nguyjo/Project_Prometheus/README.md

# Walla Walla University Prometheus Rocket Project (2025-2026)
