nguyjo/Project_Prometheus/Prometheus Final Presentation.pdf

# Prometheus Rocket Final Presentation

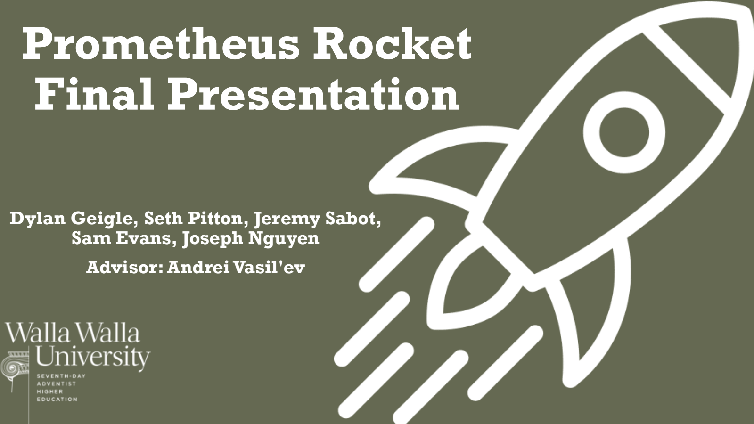
[picture p1: page 1]

Dylan Geigle, Seth Pitton, Jeremy Sabot, Sam Evans, Joseph Nguyen
Advisor: Andrei Vasil'ev

## Previous Projects

Icarus | Vulcan

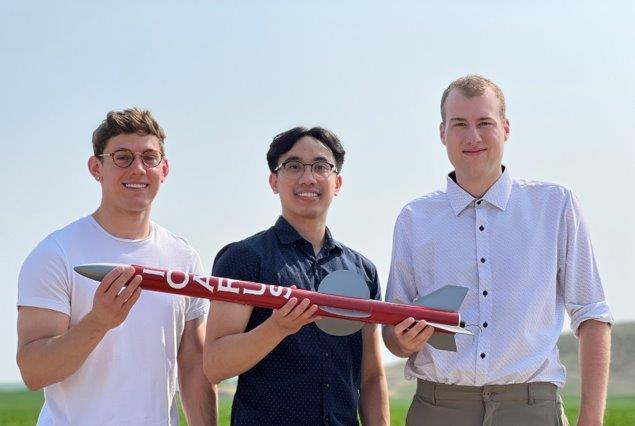
[picture p2: figure]
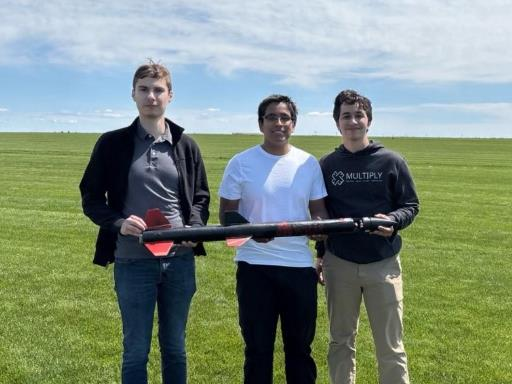
[picture p3: figure]

Figure 1. 2023 Icarus Project Team (Icarus, 2024) | Figure 2. 2024 Vulcan Project Team (Vulcan, 2025)
- Two-Stage, Cardboard
Body Rocket
- Max Altitude: 911 m
- Two-Stage, Fiberglass
Body Rocket
- Max Altitude: 1355 m

## Project Objective

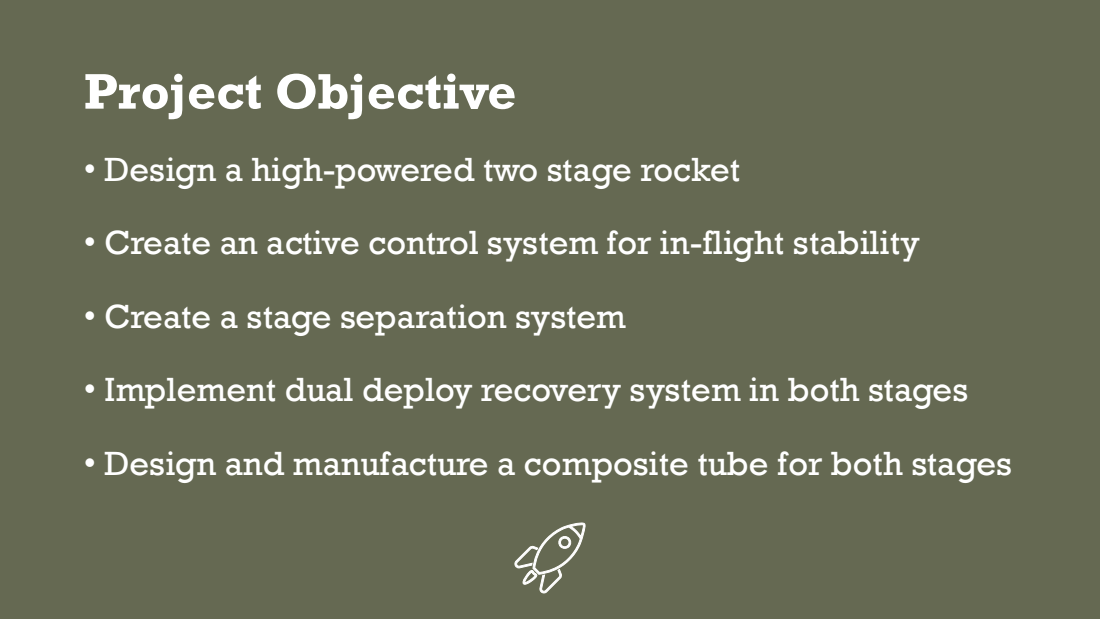
[picture p4: page 3]

• Design a high-powered two stage rocket

• Create an active control system for in-flight stability

• Create a stage separation system

• Implement dual deploy recovery system in both stages

• Design and manufacture a composite tube for both stages

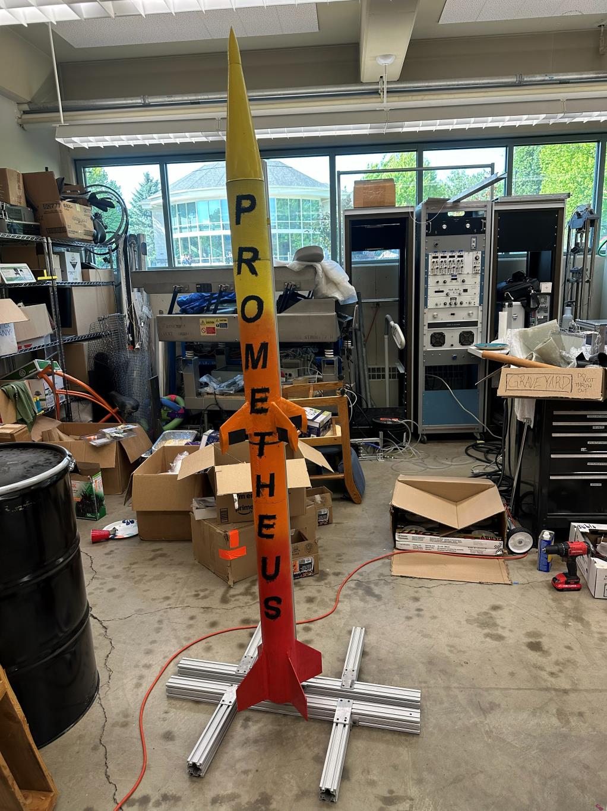
[picture p5: figure]

## Prometheus

- Max Altitude: ~7ft
- Max Velocity: ~75 mph
- We have not launched

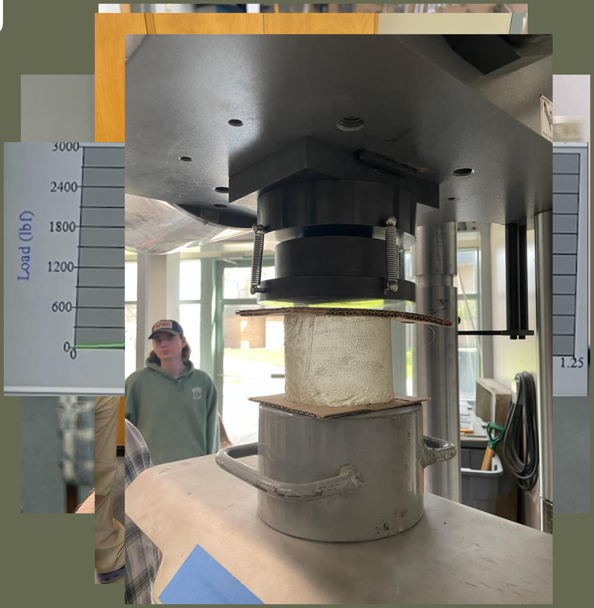
[picture p6: figure]

## Test Section Testing

- 6- layer fiberglass-epoxy composite
- 4in long
- Buckled at 2700lb (12,000N) in compression

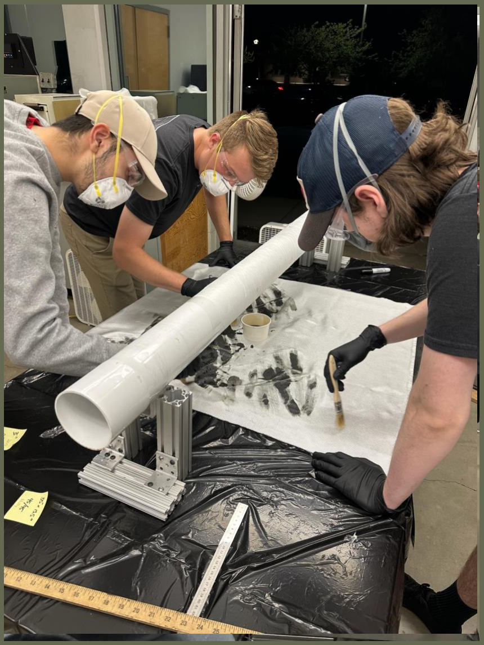
[picture p7: figure]

## Tube Manufacturing

- 6-layer fiberglass [0,45]3
- 0.7 fiber volume fraction
- 2 fiberglass layers wrapped 3 times

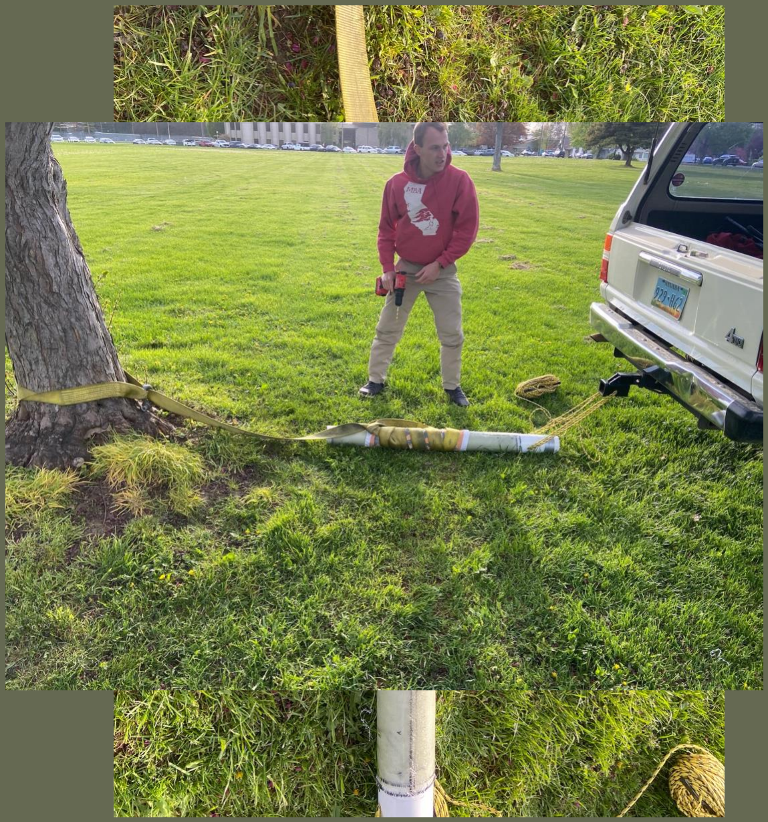
[picture p8: figure]

## Tube Removal

- Methods tried:
- Cut PVC to induce fracture
- Dremel
- Thermal (Hot/Cold)
- Melting the PVC
- Land Cruiser, Tow Strap

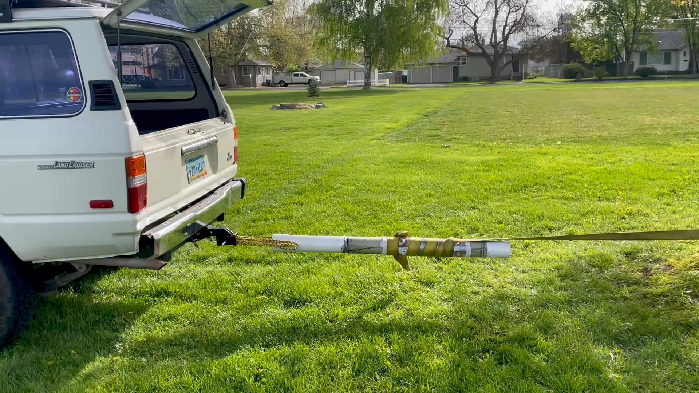
[picture p9: page 8]

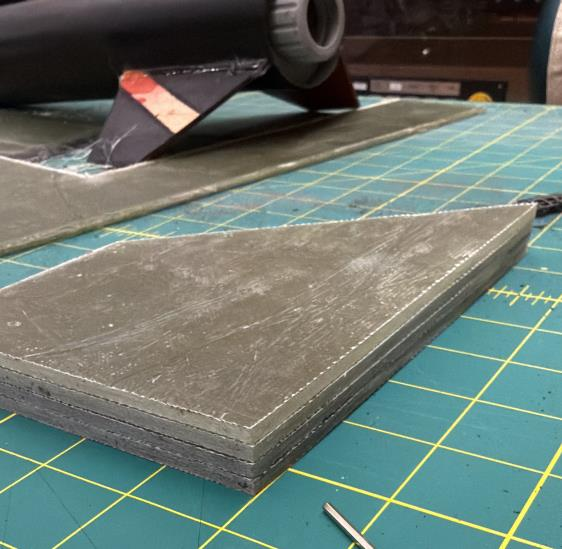
[picture p10: figure]

First Stage Fins Geometry: Trapezoidal fin set, 4 fins Root chord: 18 cm Tip chord: 8 cm Height: 11 cm Sweep length: 10 cm

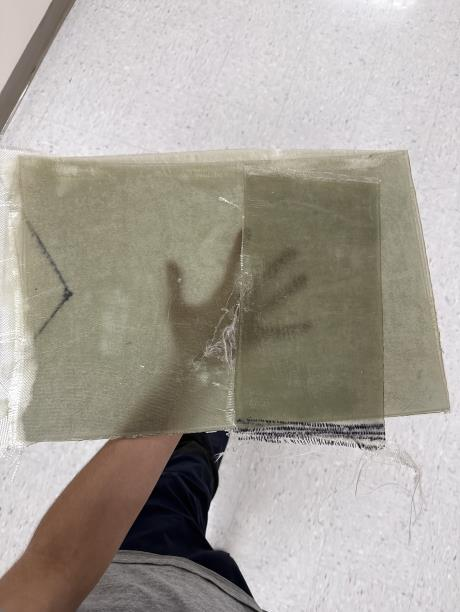
[picture p11: figure]

Manufacturing Method

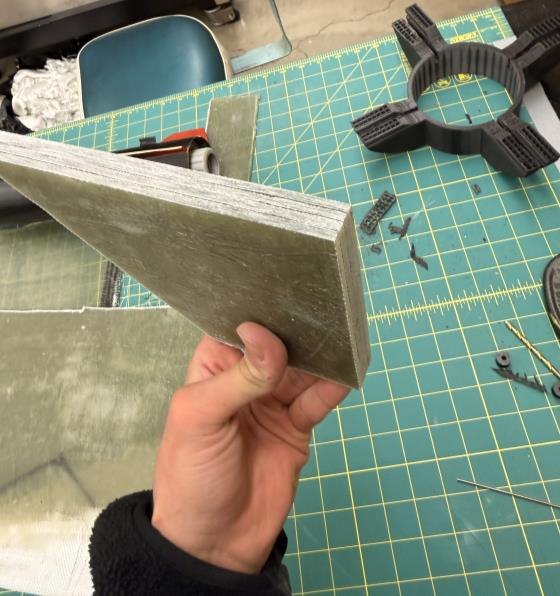
[picture p12: figure]

- Used fin root as the primary datum surface
- Flattened root edge on granite surface plate
- Checked perpendicular reference edge with a square
- Measured remaining geometry from these two references
Why It Mattered
- Improved repeatability between fins
- Reduced angular error during layout
- Helped maintain symmetry and stable flight

## Fin Attachment

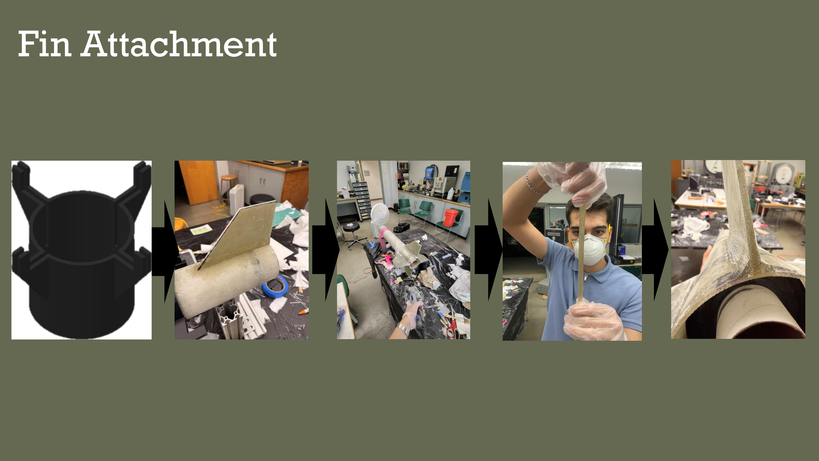
[picture p13: page 10]

## Aerodynamics

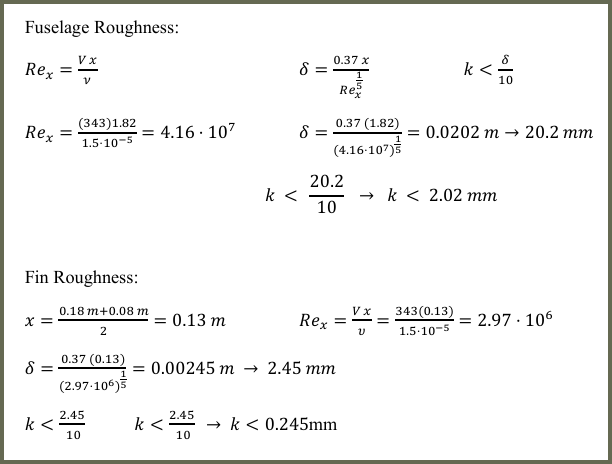
[picture p14: figure]

- Fin Shape Iteration
- Initial idea: symmetric, tapered fin profile
- Looked streamlined for incoming and exiting flow
- OpenRocket stability was too low, about 1.3 cal
- Swept-back design moved CP rearward and improved stability
- Why Sweep Back Helped

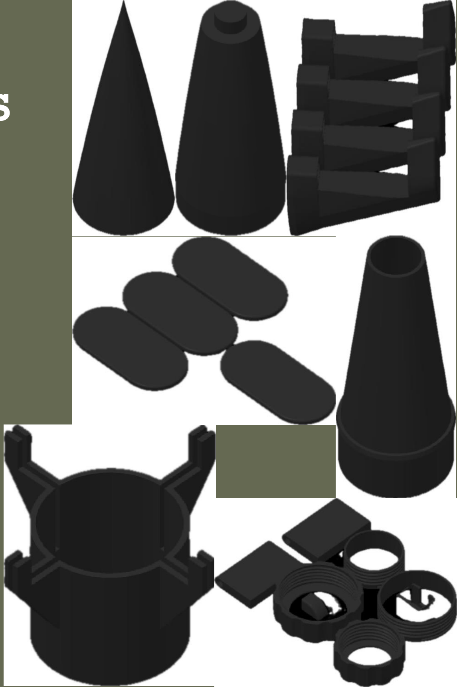
[picture p15: figure]

## 3D Printing considerations

- Stress Concentrations
- Strength Settings
- Infill Choice
- Total Printing Time: 140+ hours

## What was learned about Epoxy Resin

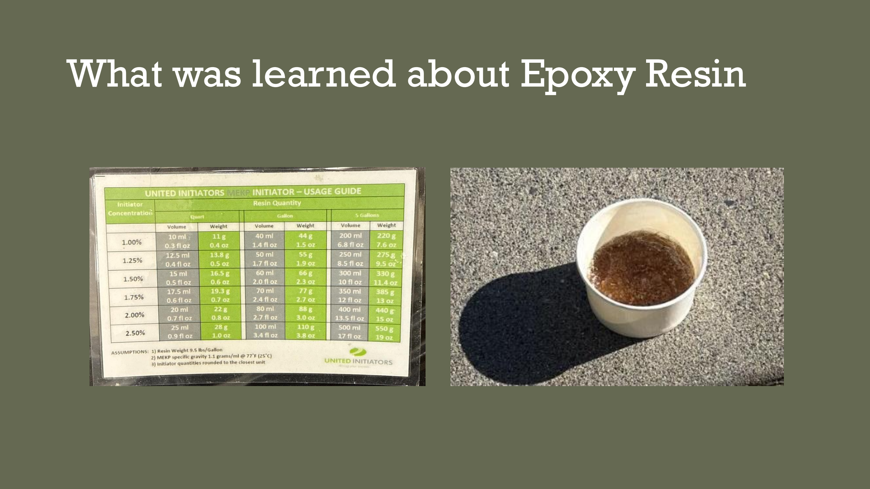
[picture p16: page 13]

2

## nd Stage Fin Manufacturing

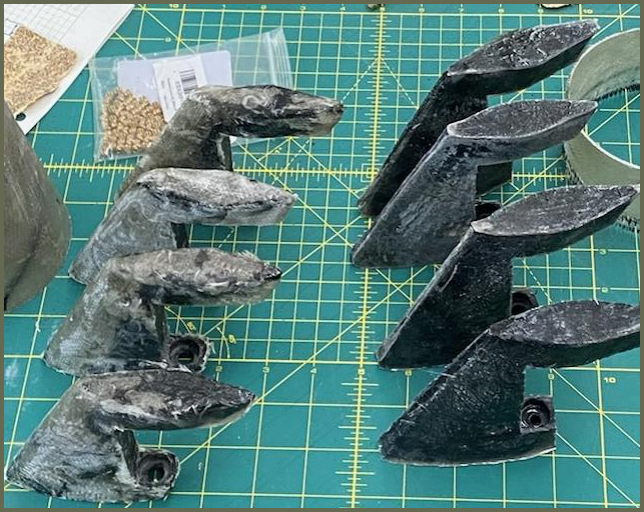
[picture p17: figure]

- 2mm thick fiberglass
- Vacuum bag to remove air bubbles
- 3d printed mold

## Control Surface Assembly

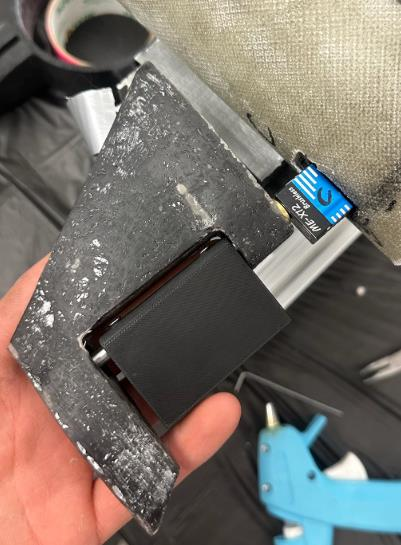
[picture p18: figure]

In House Manufactured
- Fin body (fiberglass)
- Fin Tab (3d printed)
- Shaft (1/4 in steel rod)

Purchased parts
- Servo to shaft couplers
- Bearings
- Screws

## Control Surface Assembly

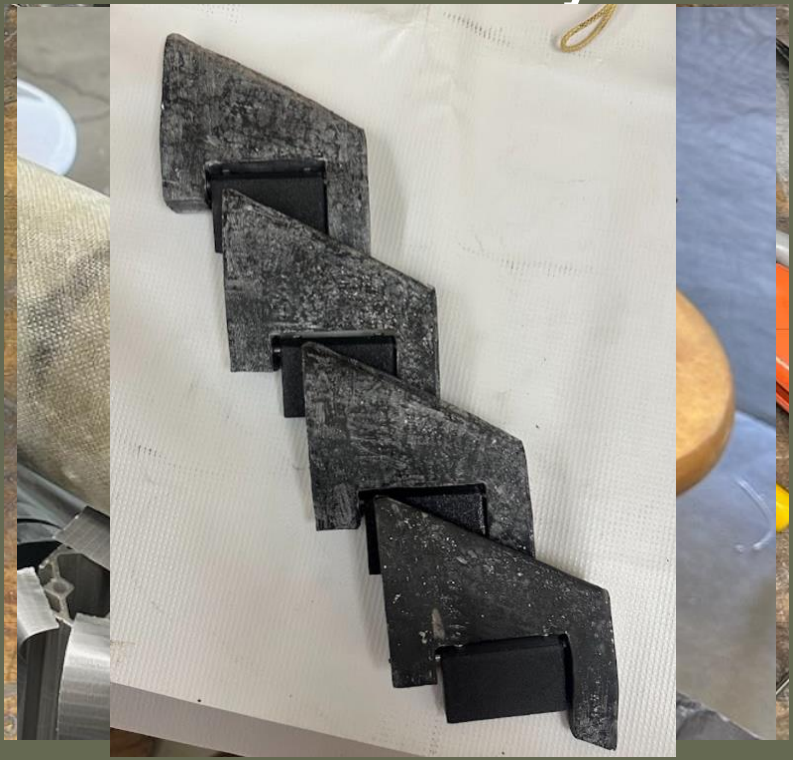
[picture p19: figure]

## What didn’t work

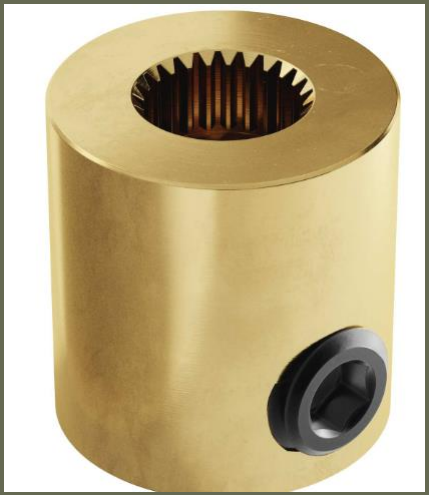
[picture p20: figure]

- Servo to shaft couplers
didn’t fit
- Solutions to this problem included plastic parts, and jb weld
- This was relatively
unsuccessful

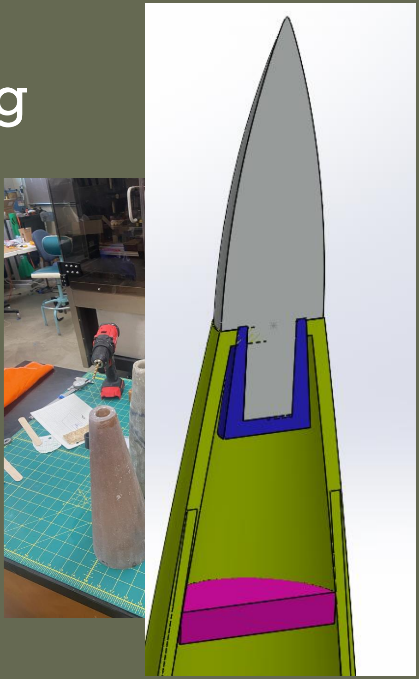
[picture p21: figure]

## Nosecone Manufacturing

- 4mm thick fiberglass
- Vacuum bag to remove air
bubbles
- 3d printed mold

## Centering Ring Redesign

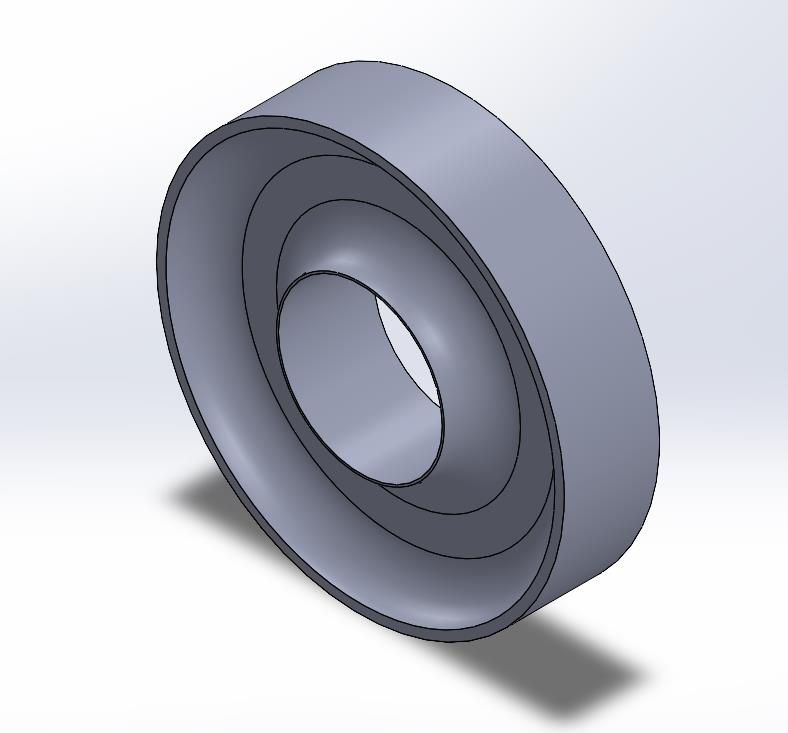
[picture p22: figure]

- Fillets had issues printing
- Increased top surface area
- Added skirts along the
outside of the rings to
increase surface adhesion

## 1st Stage Motor Mount Assembly

- Same as 2nd stage without
wires

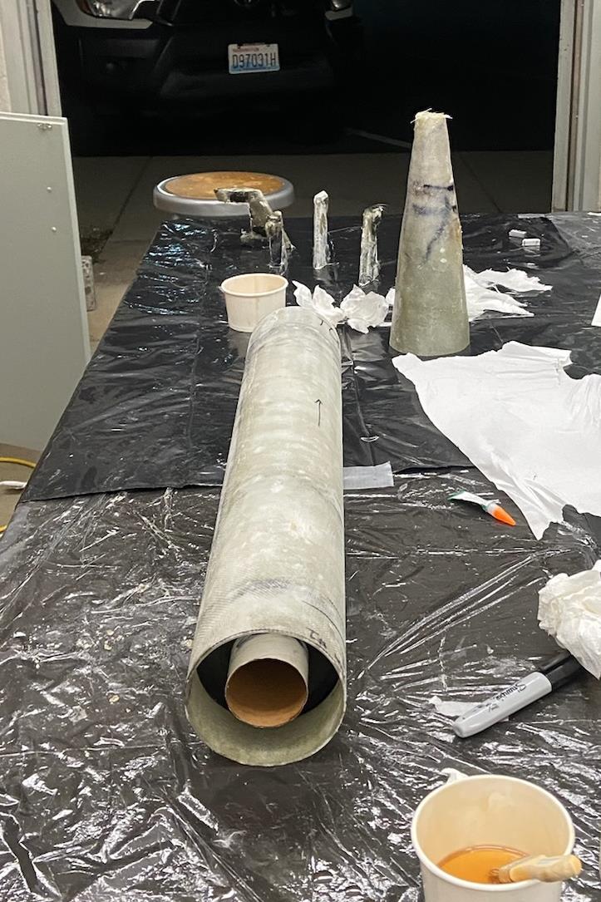
[picture p23: figure]
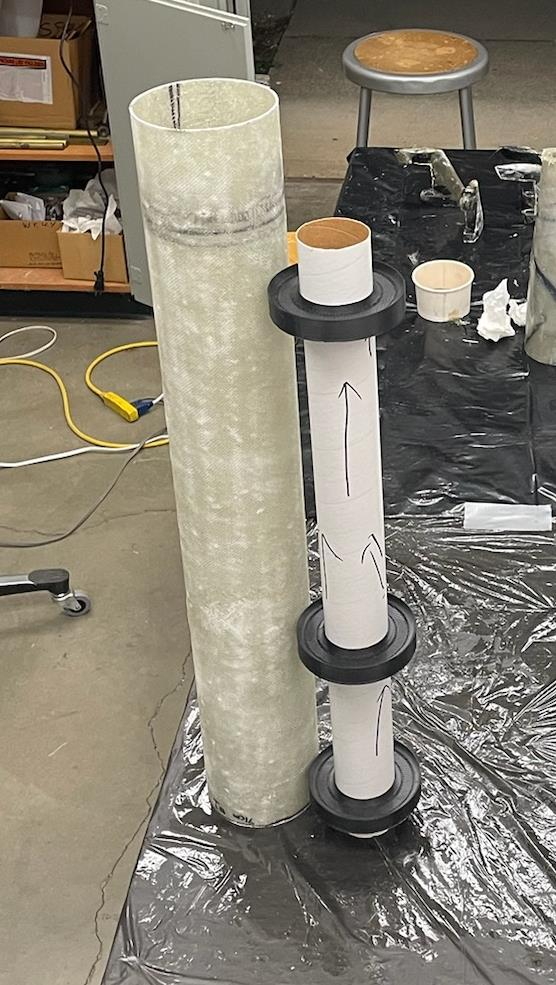
[picture p24: figure]

## 2nd Stage Motor Mount Assembly

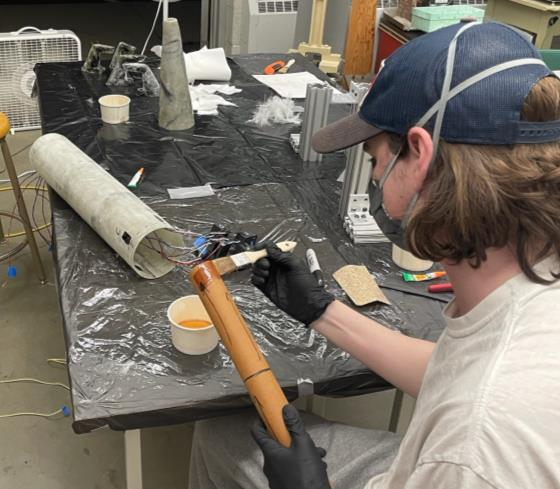
[picture p25: figure]
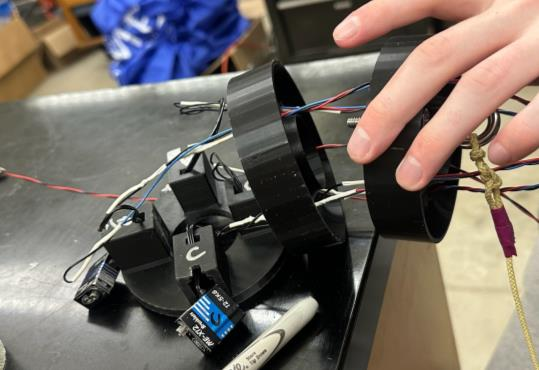
[picture p26: figure]

- Assembled outside of body
tube
- Epoxied top centering ring before motor tube
- Servos ran back through
mounting ring before
glueing in the bottom ring

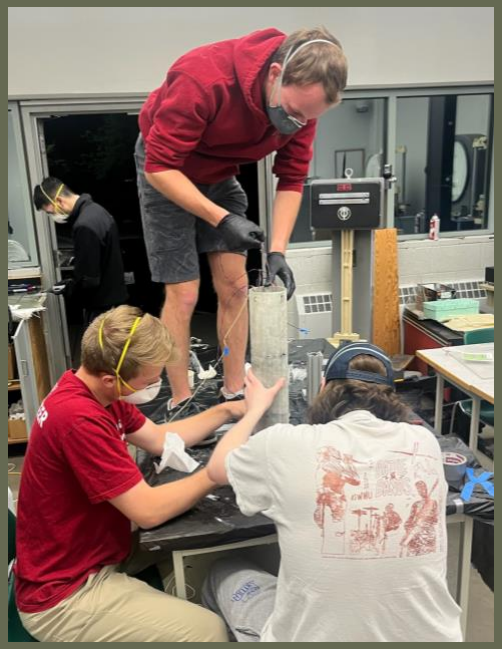
[picture p27: figure]
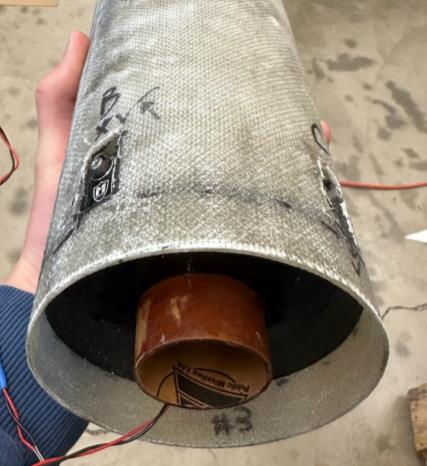
[picture p28: figure]

## First Stage Electronics Bay

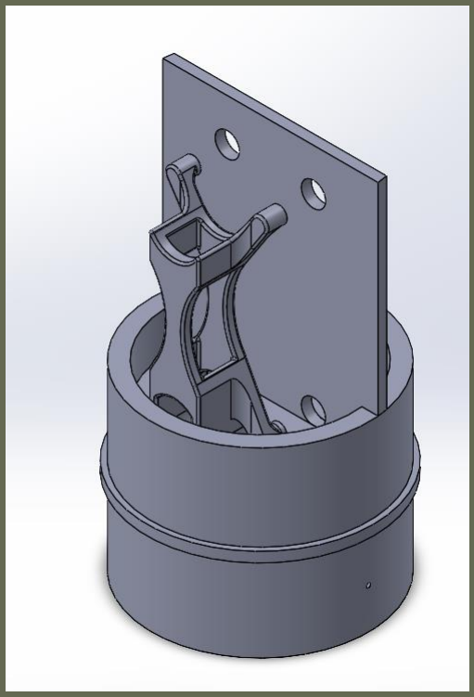
[picture p29: figure]

- Electronics
- Dual Deploy Bay
- Interstage Coupler

2

## nd Stage Electronics Bay Assembly

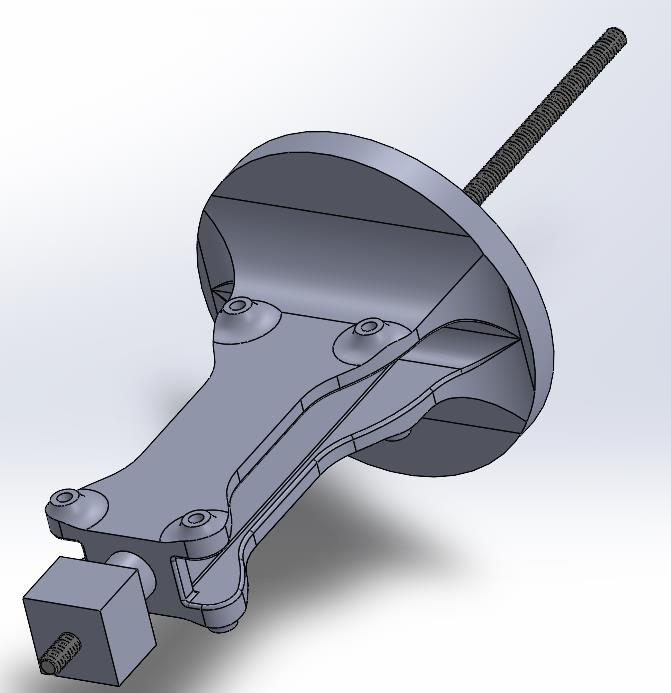
[picture p30: figure]

- Brass M3 Threaded Inserts
- Rubber washers to dampen vibration
- Large fillets for to reduce stress concentration
- Threaded rod to transfer force
- Space for 2 circuits boards, batteries

## System Block Diagram

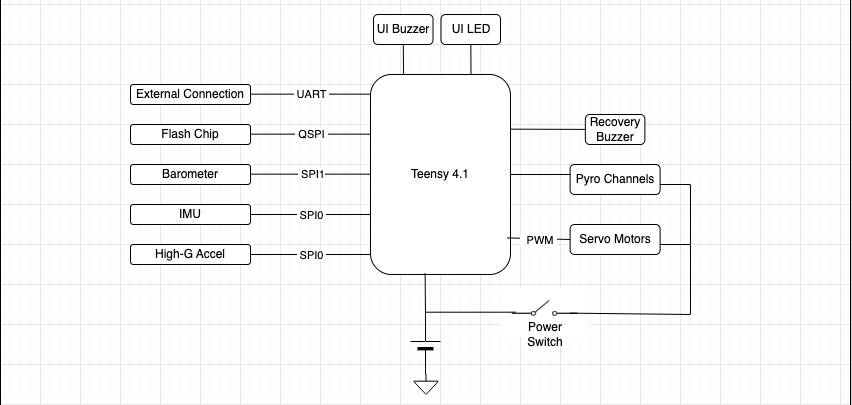
[picture p31: page 24]

## Sustainer Motor Safety Gates

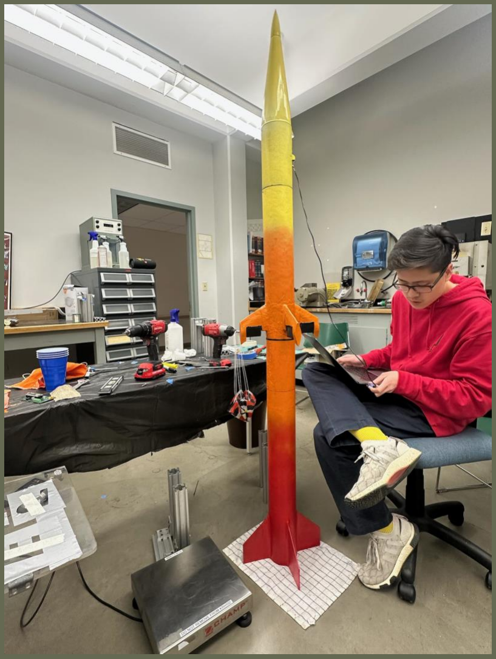
[picture p32: figure]

- Power Switch Closed
- Software Arm
- External Connection
Disconnected
- Pyro Channel Continuity
Sensing
- Booster Coast Time Elapsed
- Tilt Lockout

## Flight State Machines

Booster
- Pre-Liftoff
- Booster Ignition
- Booster Coast
- Drogue Parachute
- Main Parachute
- Touchdown

Sustainer
- Pre-Liftoff
- Booster Ignition
- Booster Coast
- Sustainer Ignition
- Sustainer Coast
- Drogue Parachute
- Main Parachute
- Touchdown

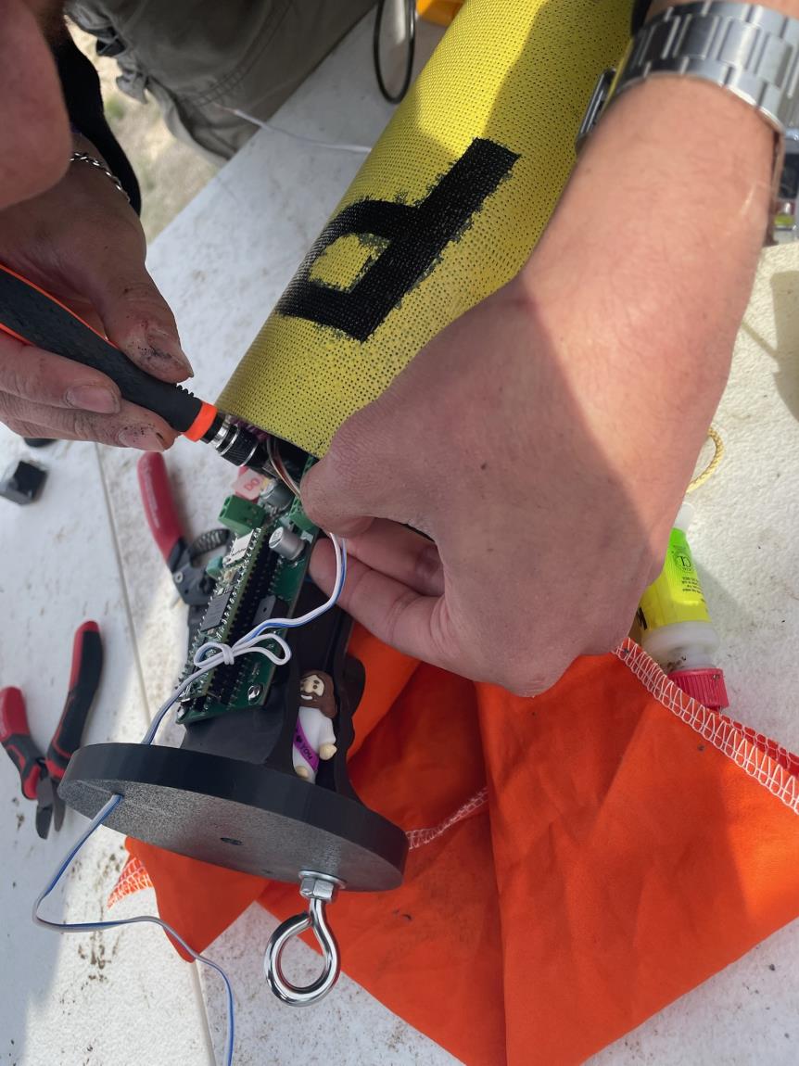
[picture p33: figure]

## Pre-Flight Safety Protocol

- Command-Line Interface (CLI)
over an External Connection
oCalibrate Sensors
- Software Arming
oBattery Voltage Monitor
oCheck Servos
- Pyro Channel Continuity
oCheck correct Firmware Upload

## Control System Block Diagram

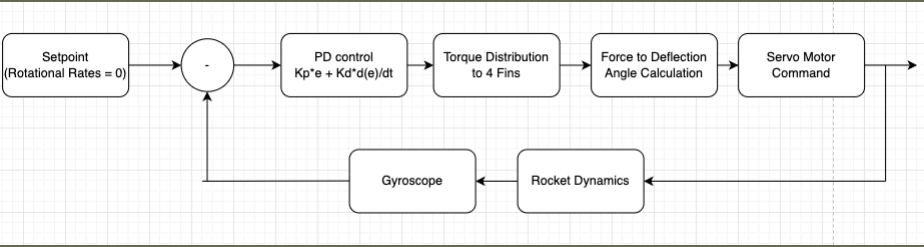
[picture p34: figure]

## Servo Motor Misalignment

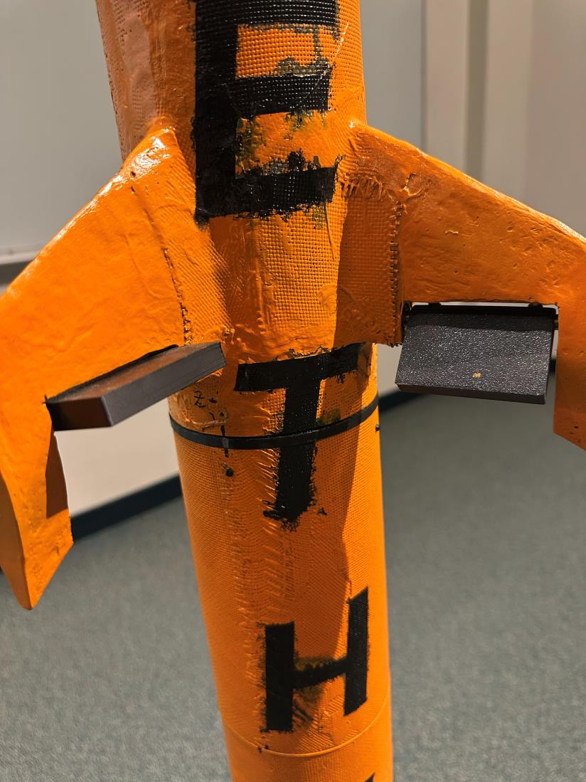
[picture p35: figure]

- During assembly, servo horns were pressed onto the splines at incorrect teeth
- Software trim/offset
can correct residual
misalignment to only a few degrees
- At commanded "neutral"
(PWM 90°), some fin tabs sat 55°+ off parallel-to-airframe

## Sam Does Electrical Engineering

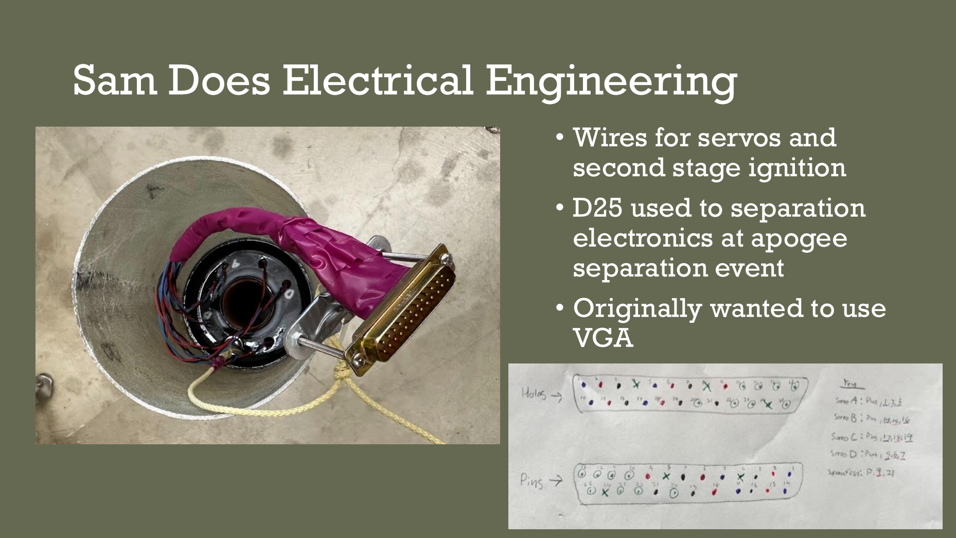
[picture p36: page 30]

- Wires for servos and
second stage ignition
- D25 used to separation
electronics at apogee
separation event
- Originally wanted to use VGA

## Camera Housing

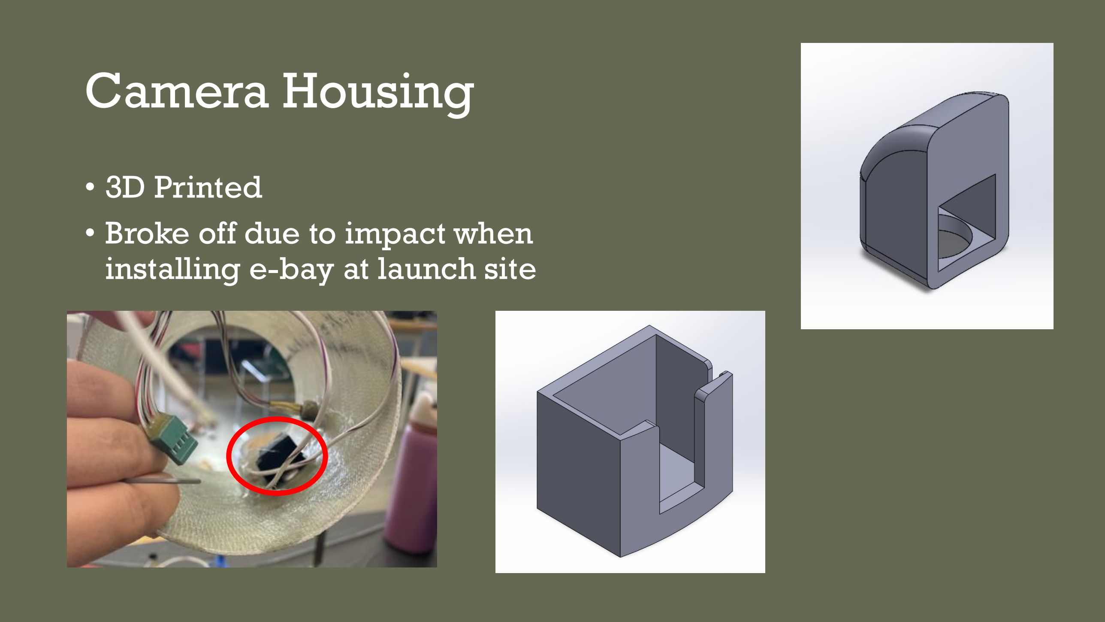
[picture p37: page 31]

- 3D Printed
- Broke off due to impact when installing e-bay at launch site

## Motors

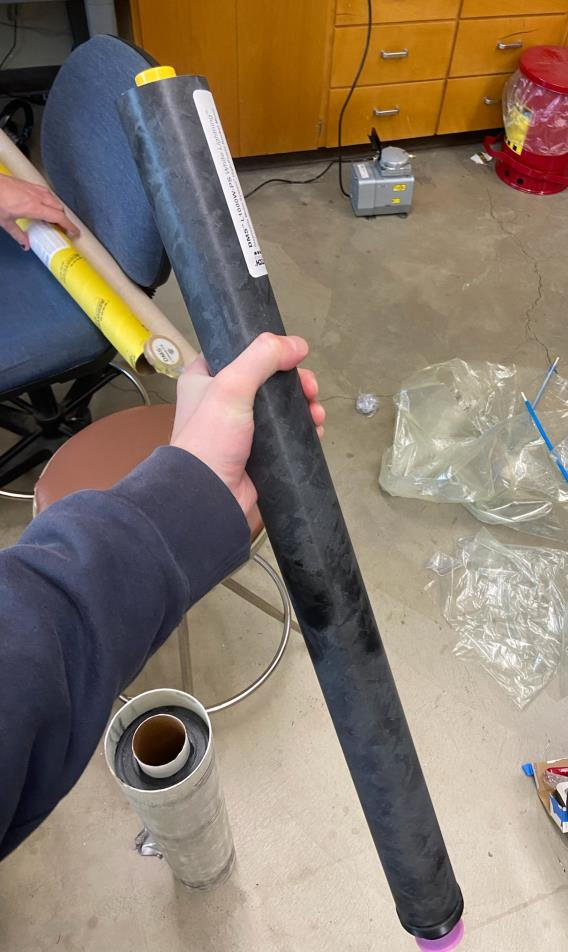
[picture p38: figure]
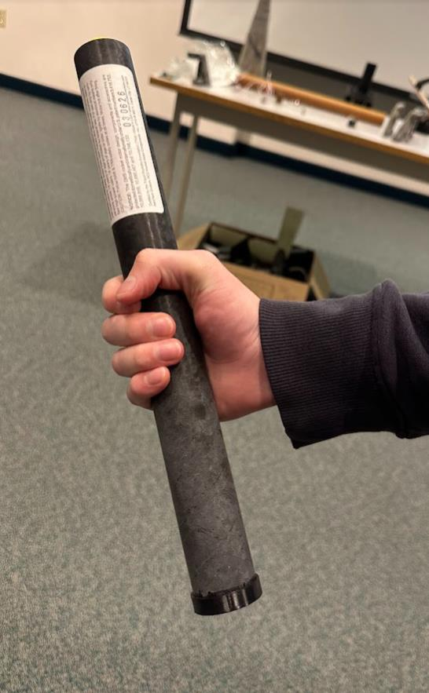
[picture p39: figure]

- L1000-18
- Burn Time: 3s
- Coast Time: 7s
- Max Thrust: 1355N
- J435-14
- Burn Time: 1.78s
- Coast Time: 14s
- Max Thrust: 696N

## Motor Retention Caps

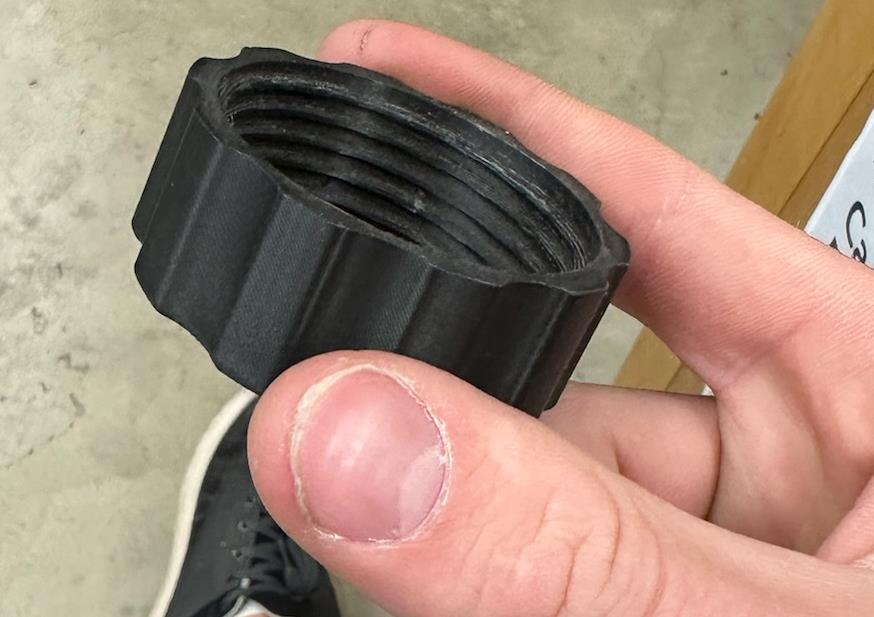
[picture p40: figure]
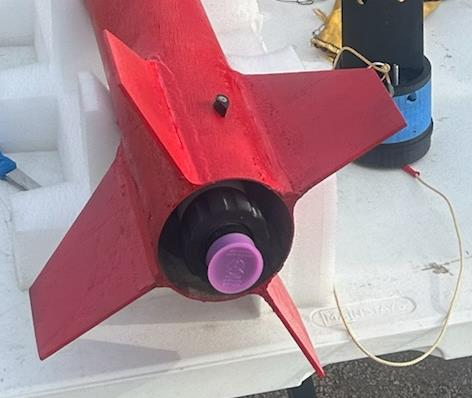
[picture p41: figure]
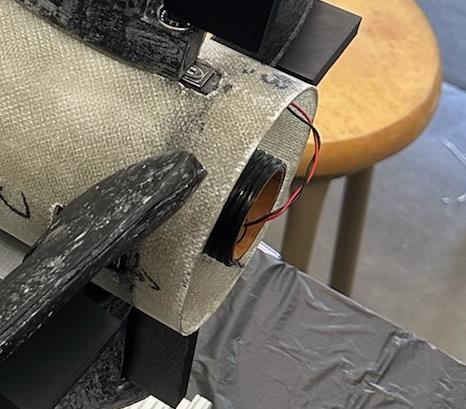
[picture p42: figure]
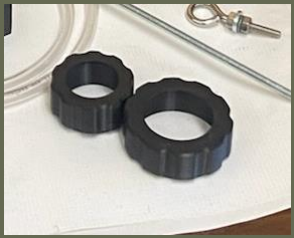
[picture p43: figure]

- Made to hold the motors in
the mounting tubes
- 3d printed
- Epoxied onto the motor
mount tubes

## Recovery

- The recovery system went together as intended
- Assemblies approved for
flight after intense
questioning

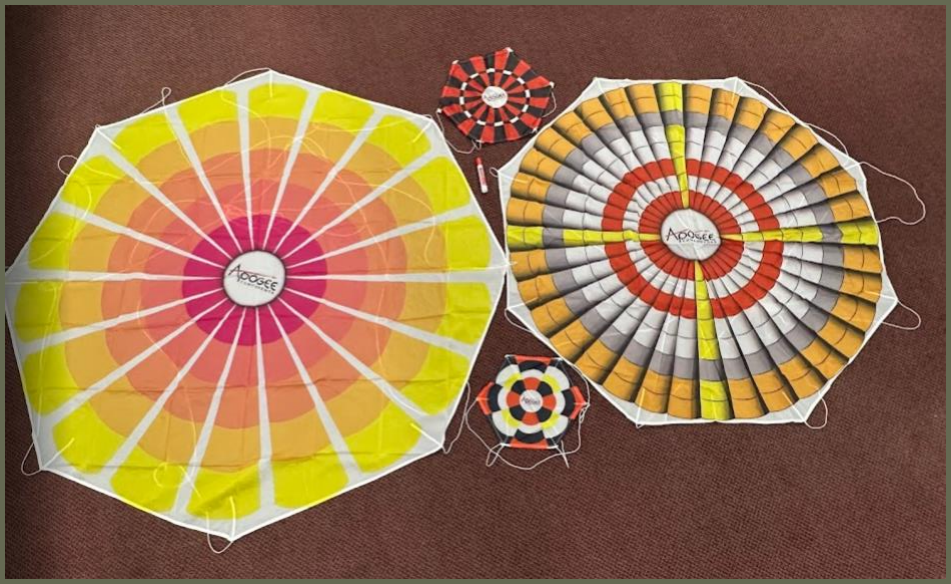
[picture p44: figure]

## Charges

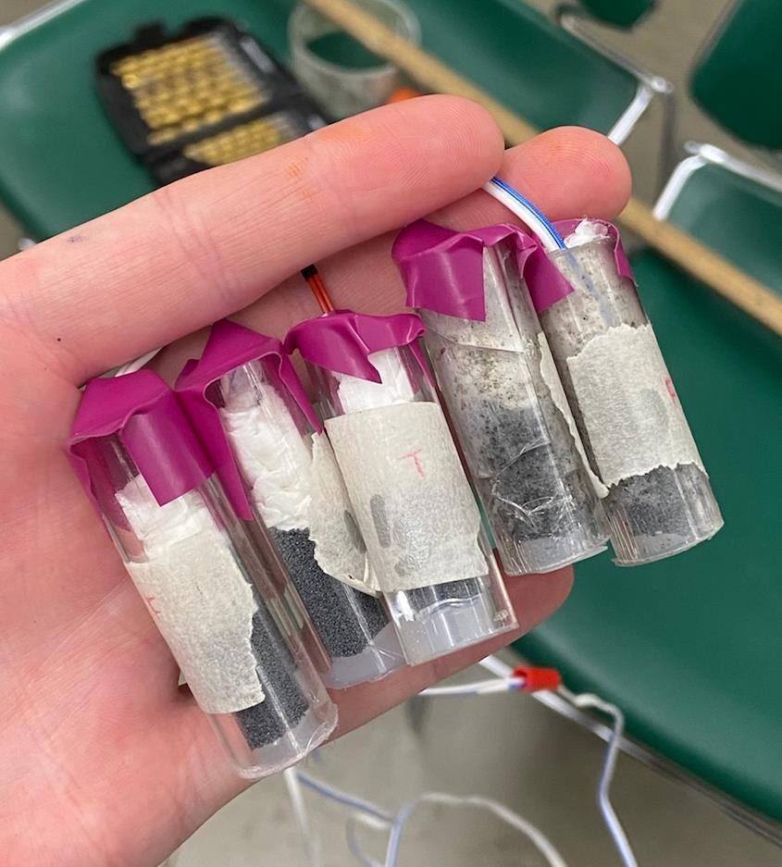
[picture p45: figure]

- Initial
- H335 Rifle Powder
- Tested with 7g+
- Final
- Triple Seven FFFG
- 1g
- Finer and more energetic than H335
- Plastic Tubing
- Hot glue
- Paper towel

## Charge Testing

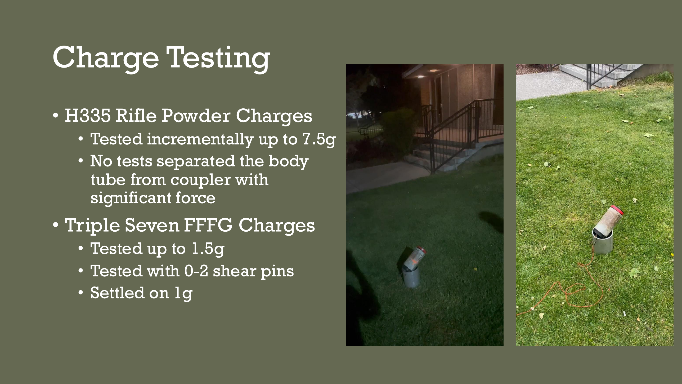
[picture p46: page 36]

- H335 Rifle Powder Charges
- Tested incrementally up to 7.5g
- No tests separated the body tube from coupler with
significant force
- Triple Seven FFFG Charges
- Tested up to 1.5g
- Tested with 0-2 shear pins
- Settled on 1g

## Final Assembly

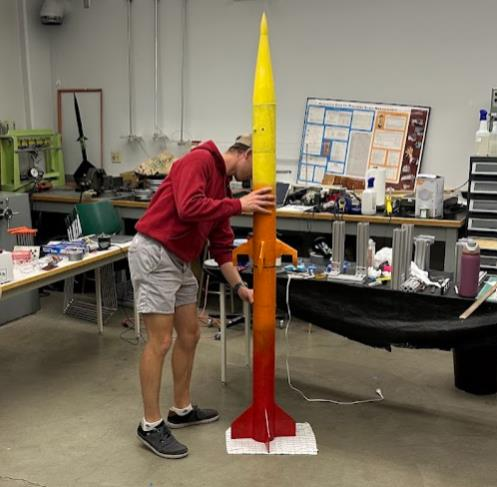
[picture p47: figure]

- Chute lines tied off
- Parachutes packed
- Electronics bays aligned
- Shear pins installed
- Final checks made

## OpenRocket Projections

- Max Velo: 279 m/s (Mach 0.8)
- Max Acceleration: 173 m/s^2
- Apogee: 3220 m (~10.5k ft)
- Weight: 8 kg
- Weight (no motors): 5.2 kg
- Real Weight: 4.92 kg

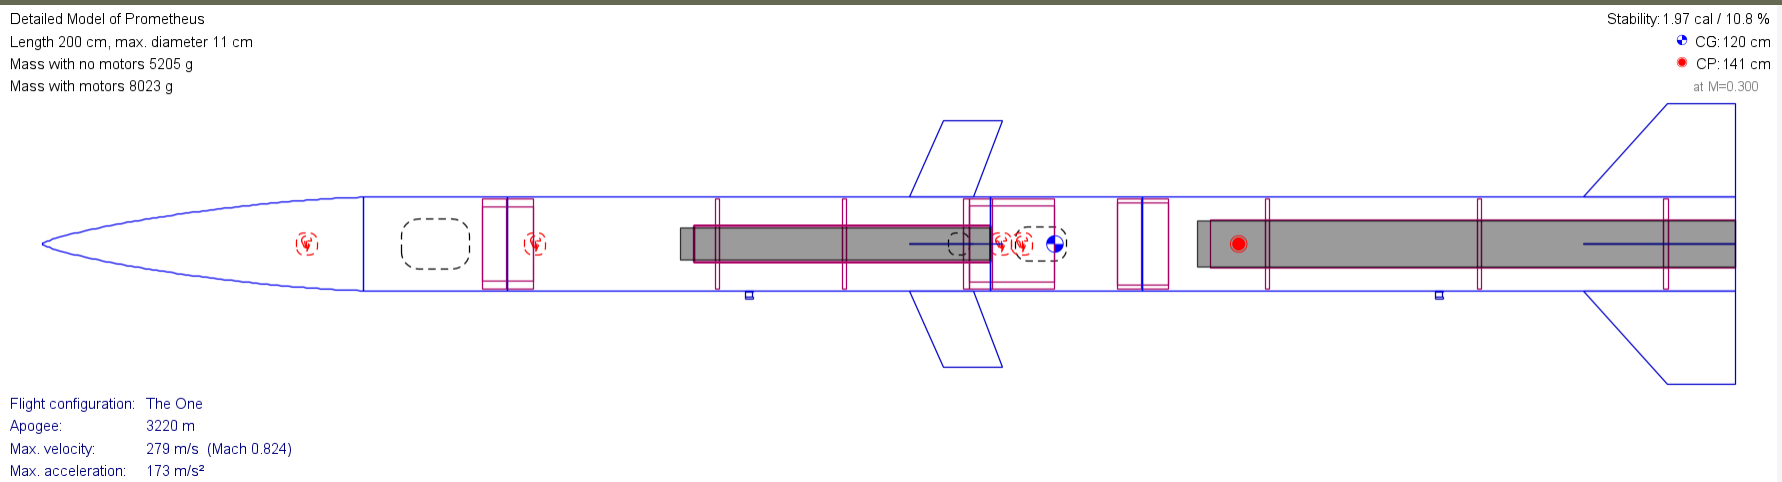
[picture p48: figure]

# Budget

| Electronics | Motors | Miscellaneous | Total
Cost | $963.55 | $442 | $270.63 | $1676.28

## So Why Did Prometheus Not Launch?

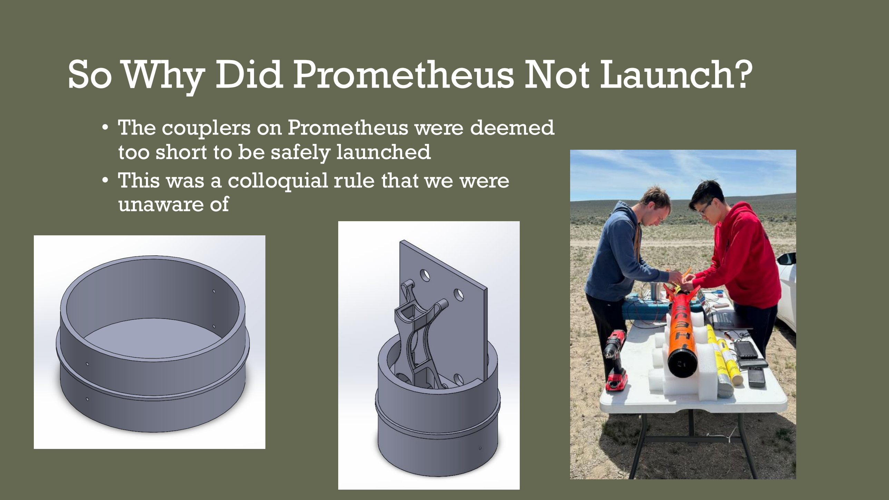
[picture p49: page 40]

- The couplers on Prometheus were deemed too short to be safely launched
- This was a colloquial rule that we were unaware of

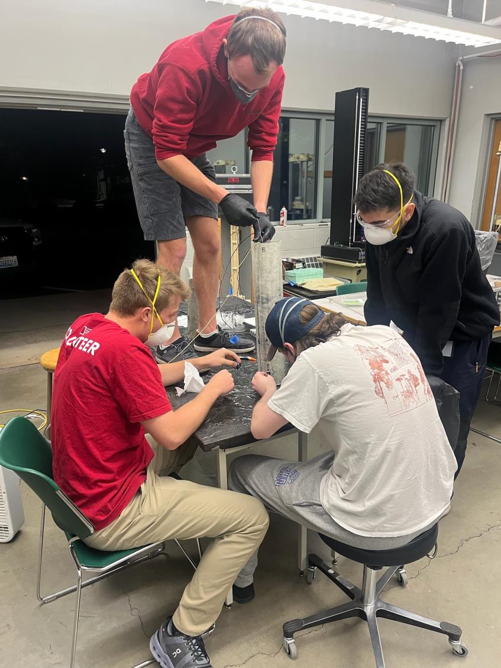
[picture p50: figure]

## Man Hours

- In total roughly 1400+ man hours to build
- Capstone requires 150 per person
- That’s roughly 9 people in project hours
| Fall | Winter | Spring | Quarter Totals | Total
Dylan | 64 | 87 | 124 | 275 | 1417
Sam | 56 | 79 | 144 | 279
Seth | 65 | 71 | 144 | 280
Jeremy | 50 | 70 | 130 | 250
Joseph | 60 | 78 | 160 | 298
Andrei | 5 | 10 | 35 | 50

## Advice to Future Projects (That We Wish We Knew)

- Hardware-in-the-Loop (HIL) testing simulation
- Extensive materials testing on epoxy, PETG and
assembly hardware
Problems from our Rocket:
- Redesign couplers
- Solve space issue
- Fix brass coupler(s)
- Materials testing
- Leave time for testing

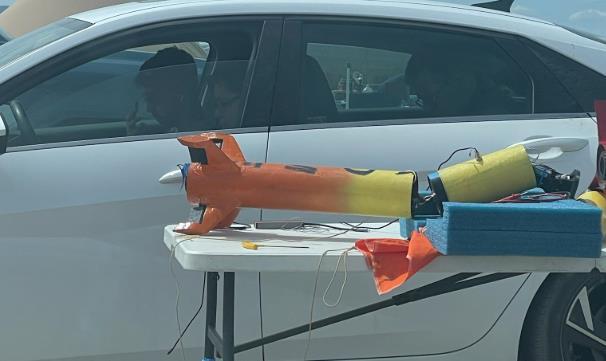
[picture p51: figure]

Credits • Andrei Vasilev • Dr. Thomsen • Reiff Manufacturing • Dr. Ekkens • Andrei Maiorov • Kolby Kriegelstein • Natalie Hunter • Jess Mumek • Dr. Ma • Dr. Yaw

- Cristina Showalter • Toby Pitton • Carena Tomas • Seth Waller • David Bobocea • Colten Hartman • Xander Rusenescu • ASME Club • Sam’s car • Tree on Rogers field

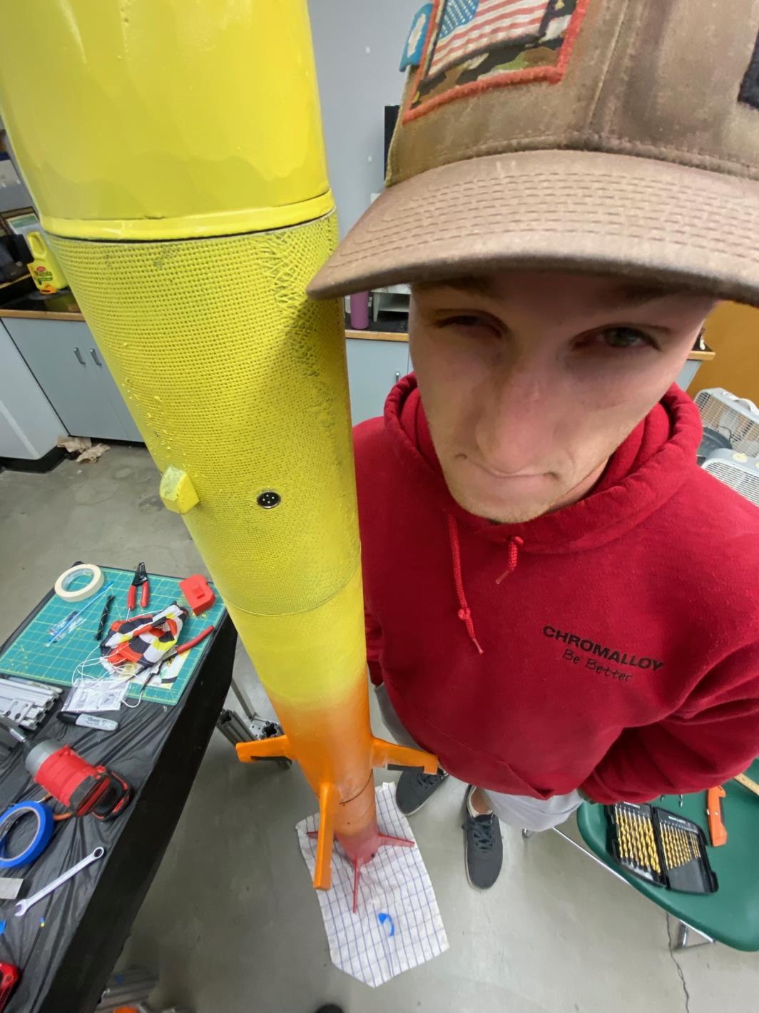
[picture p52: figure]

## Questions?

All uncredited photos were taken by the Prometheus rocket project team
