nguyjo/Project_Prometheus/hardware/KiCAD/Pronoia_Sustainer/CAD Results/Pronoia_Sustainer_v2.0.png

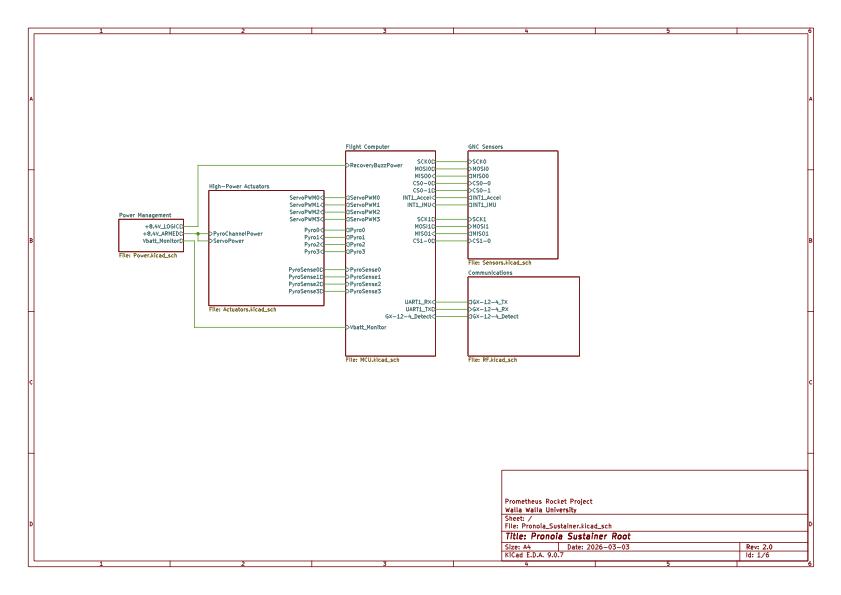
hardware/KiCAD/Pronoia_Sustainer/CAD Results/Pronoia_Sustainer_v2.0.png
