nguyjo/Project_Prometheus/hardware/KiCAD/Pronoia_Sustainer/CAD Results/Pronoia_Sustainer.pdf

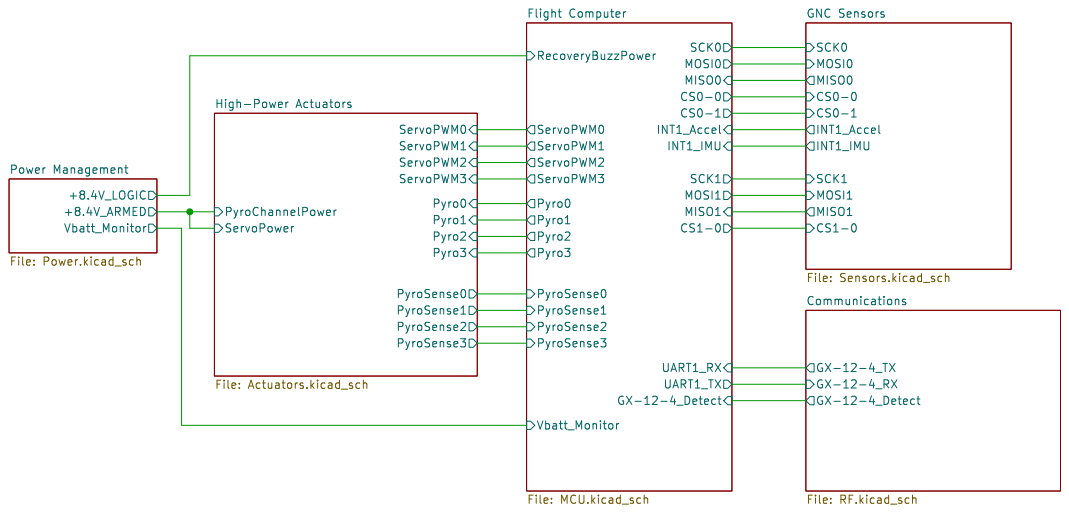
[picture p54: page 1]

INT1_Accel INT1_IMU MISO0 MOSI0 SCK0 CS1-0 MISO1 MOSI1 SCK1 GNC Sensors File: Sensors.kicad_sch GX-12-4_RX GX-12-4_TX GX-12-4_Detect Communications File: RF.kicad_sch Vbatt_Monitor +8.4V_ARMED

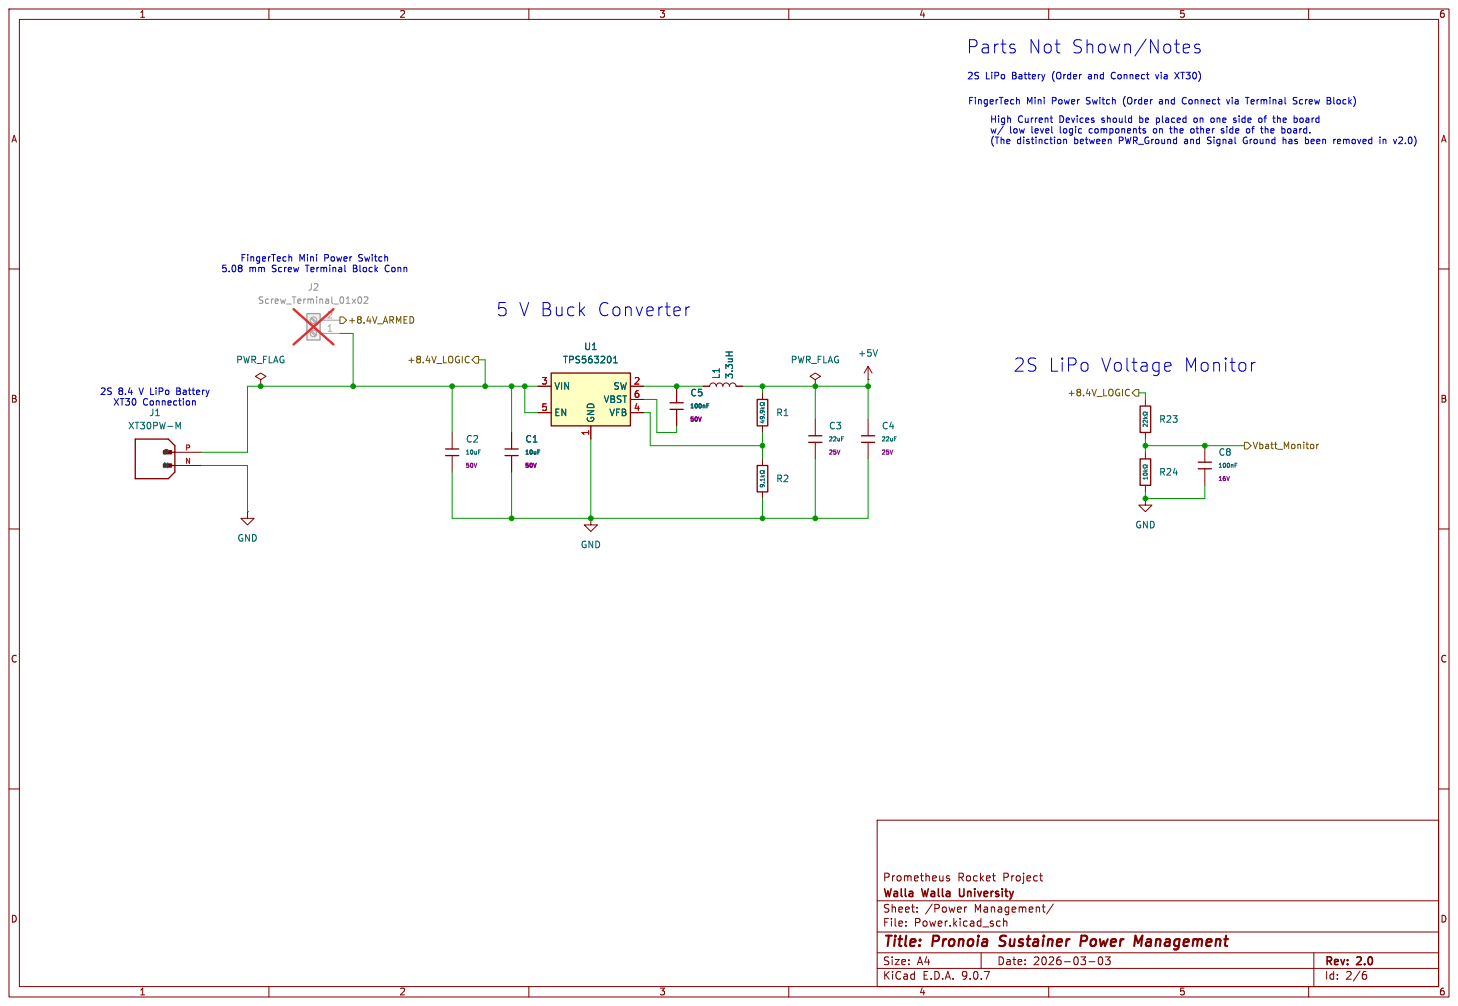
[picture p55: page 2]

FingerTech Mini Power Switch (Order and Connect via Terminal Screw Block) 2S LiPo Battery (Order and Connect via XT30)

FingerTech Mini Power Switch

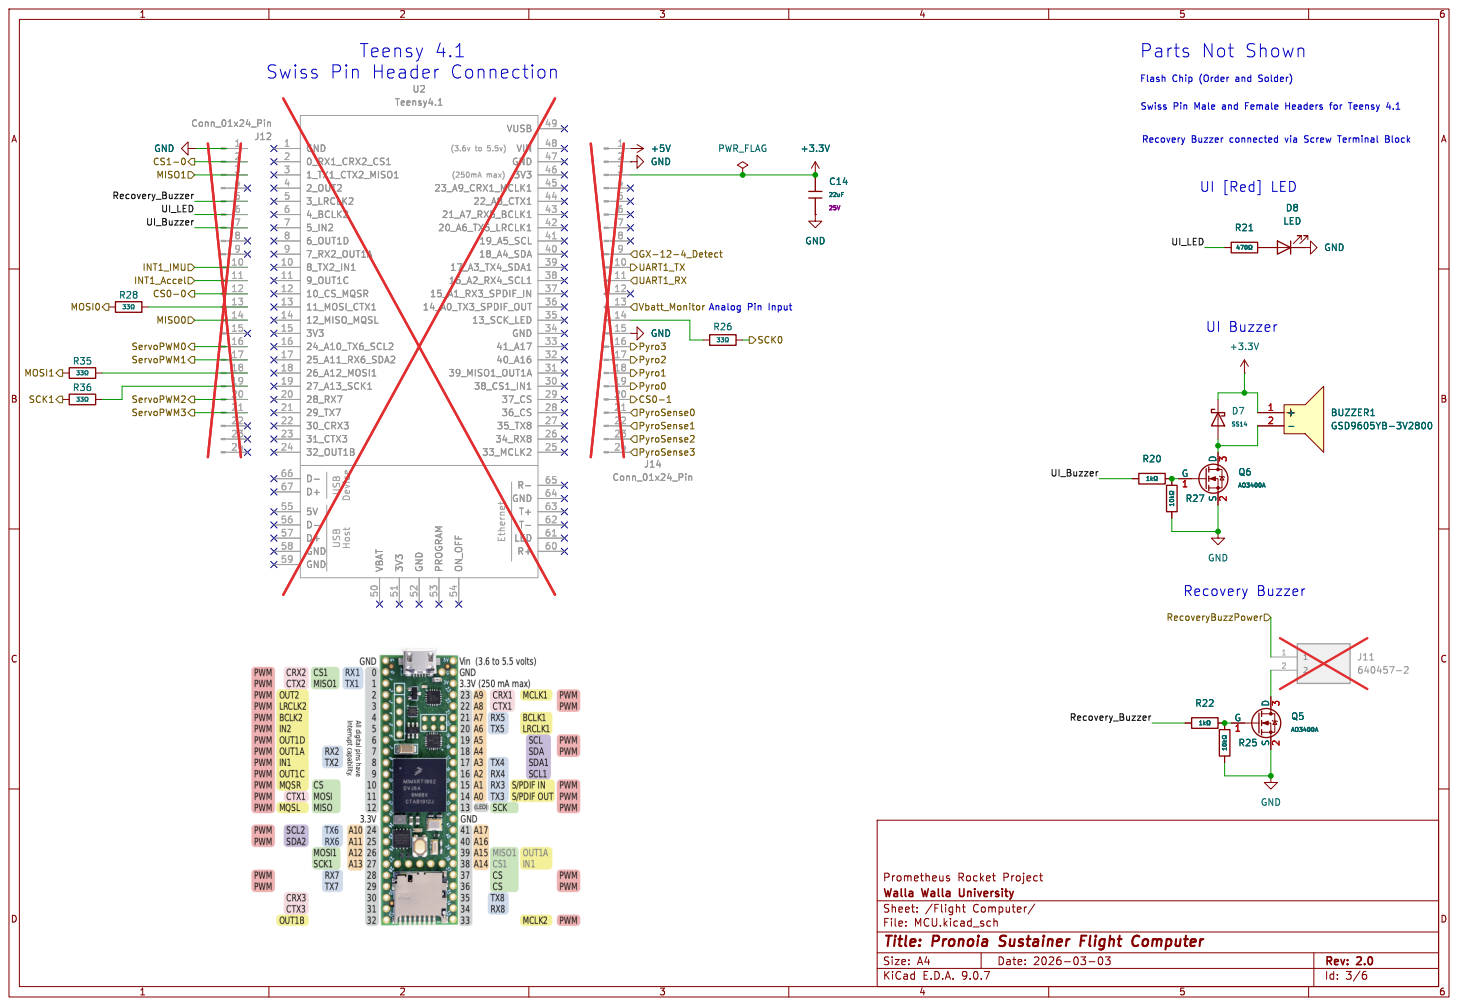
[picture p56: page 3]

Swiss Pin Header Connection

Flash Chip (Order and Solder)

LED USB USB Device Host

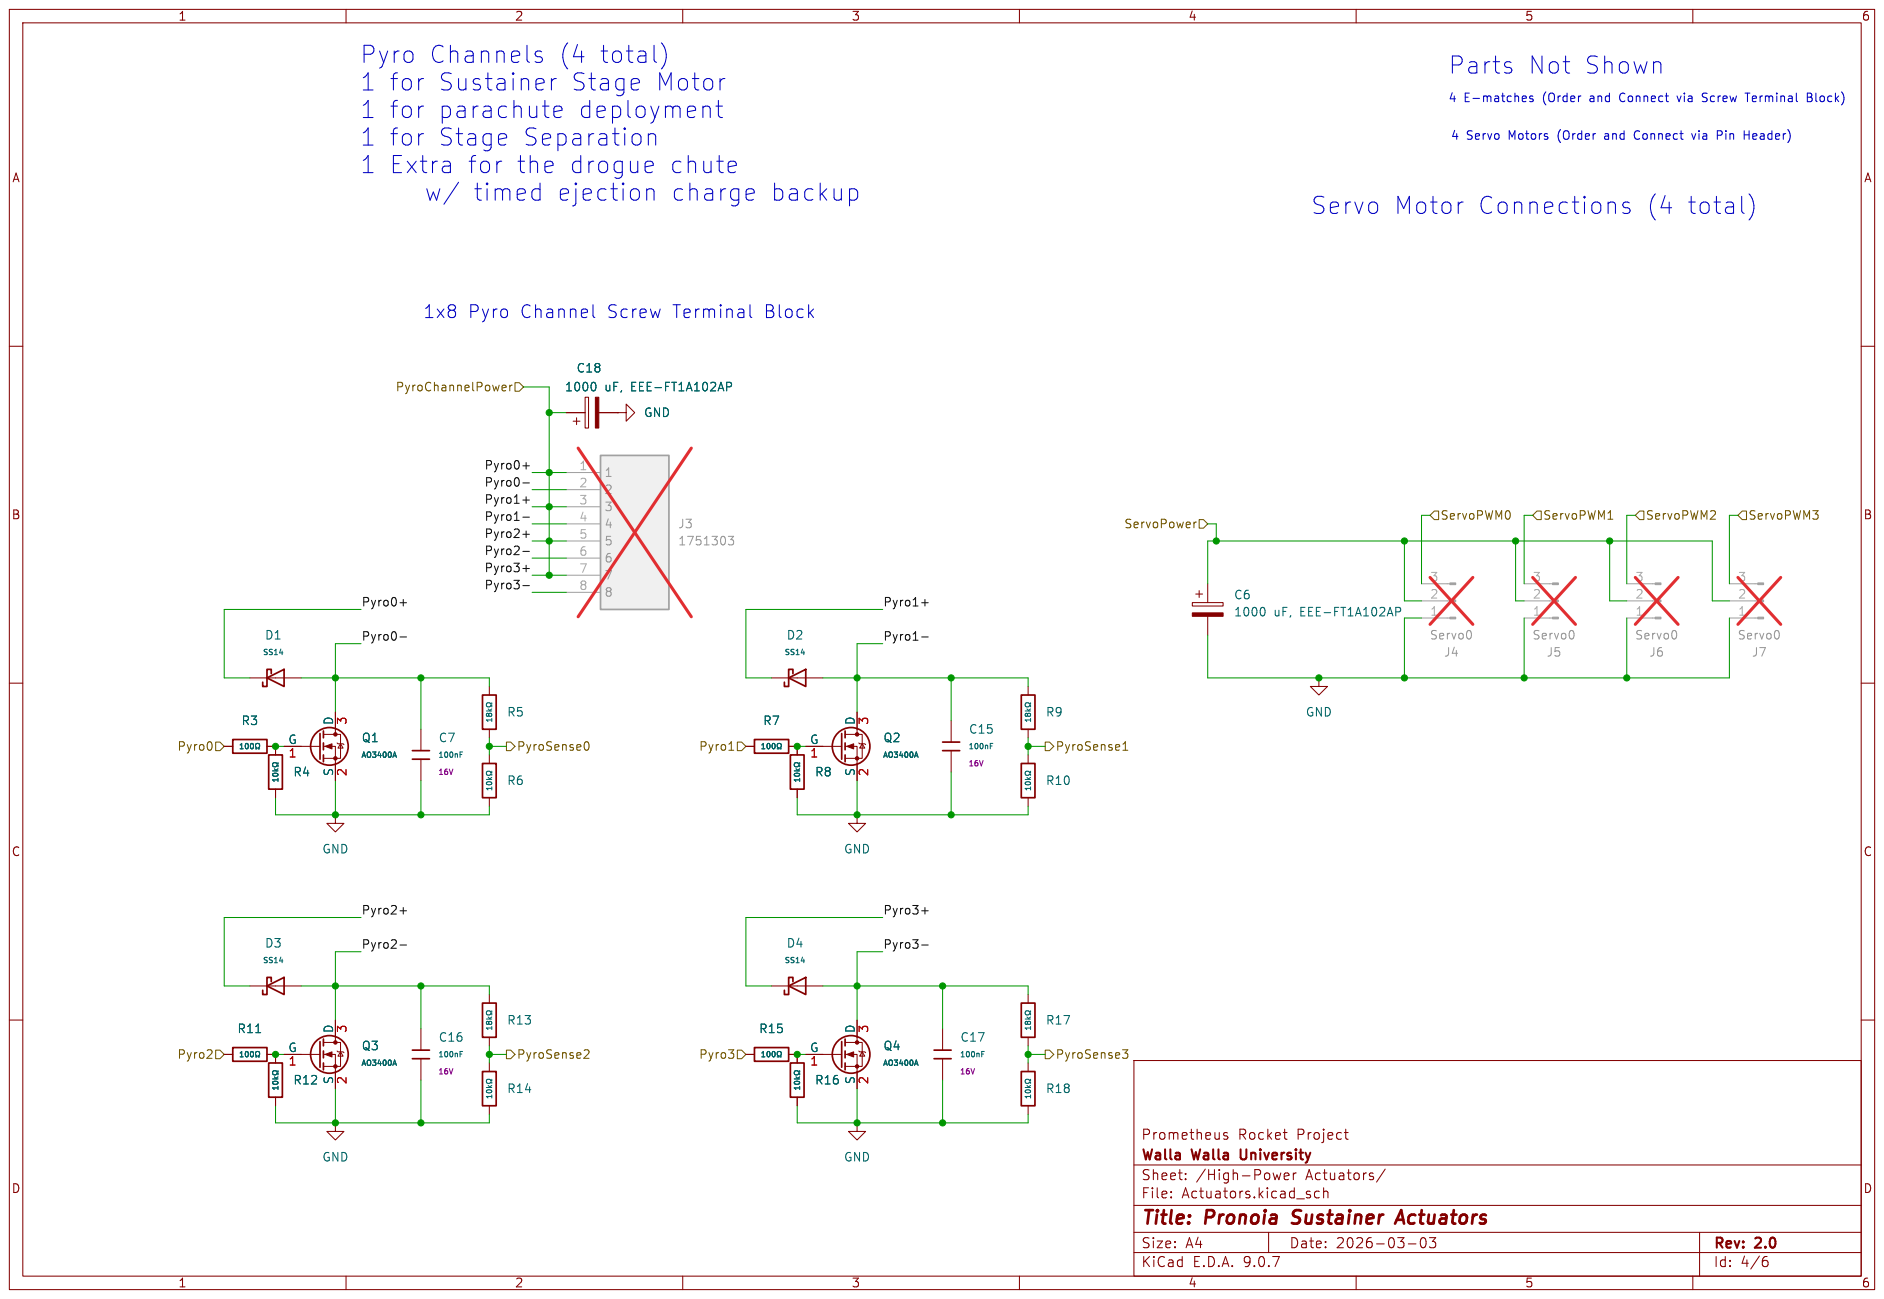
[picture p57: page 4]

Pyro Channels (4 total)
1 for Sustainer Stage Motor
1 for Stage Separation
1 Extra for the drogue chute
þÿ100© GND

4 Servo Motors (Order and Connect via Pin Header)

1x8 Pyro Channel Screw Terminal Block

Id: 4/6 Title: Pronoia Sustainer Actuators

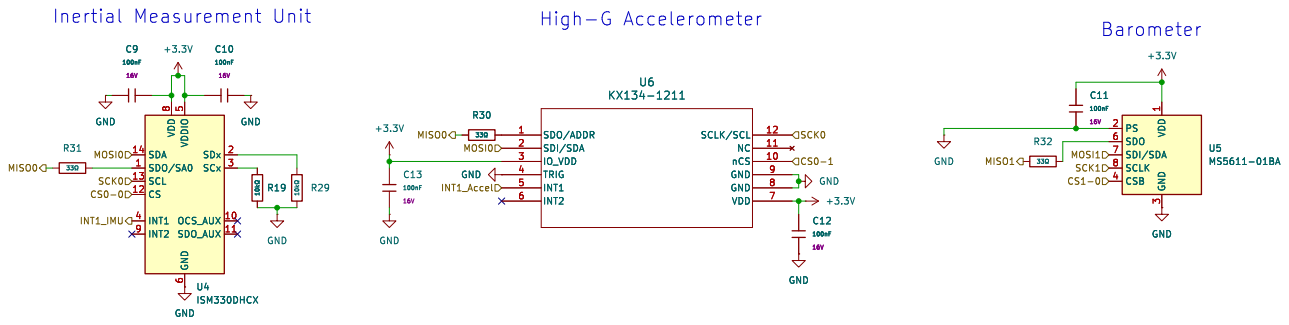
[picture p58: page 5]

6 SDx 2 SCx 3 OCS_AUX 10 SDO_AUX 11 GND GND

Id: 5/6 Title: Pronoia Sustainer Sensors

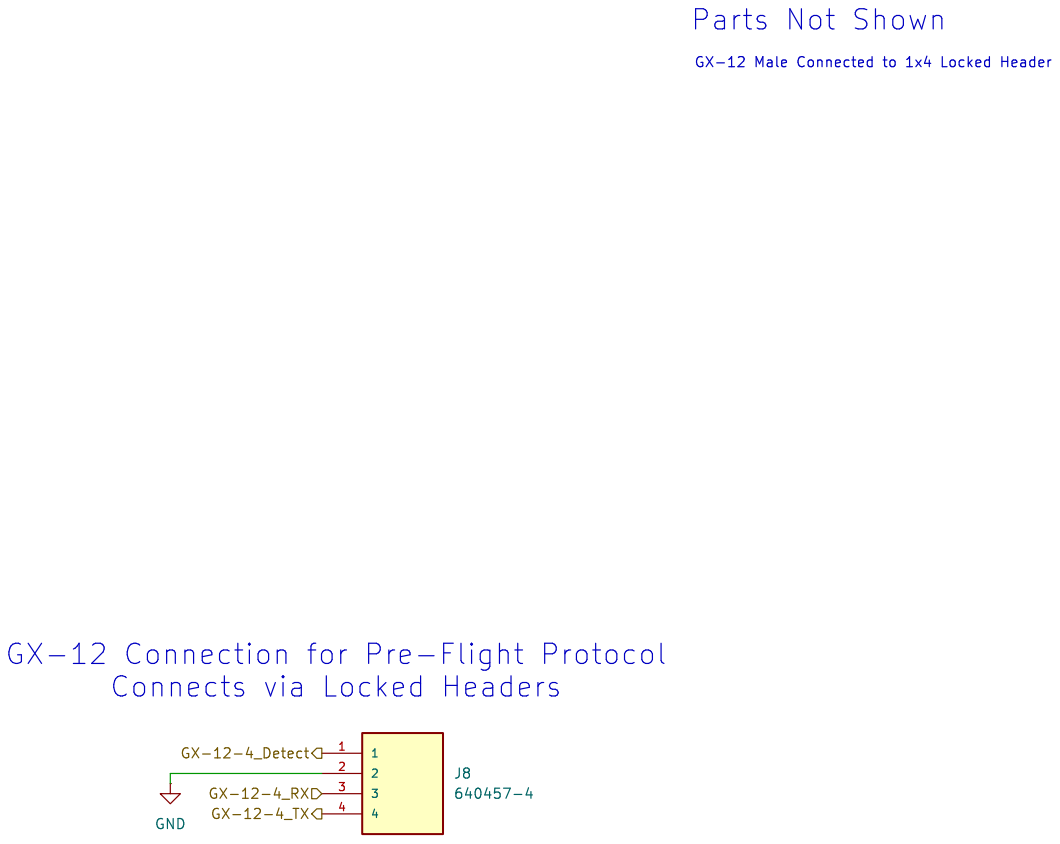
[picture p59: page 6]

Id: 6/6 Title: Pronoia Sustainer Communications
