nguyjo/Project_Prometheus/simulation/electrical/PyroChannel/Pyro Channel Sim.asc

D1: diode; SS24
M2: nmos; Si4430DY
R1: res; 1
R2: res; 100
R3: res; 10k
R4: res; 10k
R5: res; 18k
V1: voltage; 8.7; Rser=0.05
V2: voltage; PULSE(0 3.3 10m 1u 1u 1 2)
Named nets: 0
.tran 50m
