nguyjo/Project_Prometheus/hardware/KiCAD/Pronoia_Sustainer/Pronoia_Sustainer.kicad_pcb

## KiCad design hardware/KiCAD/Pronoia_Sustainer/Pronoia_Sustainer.kicad_pcb (2026-06-22)

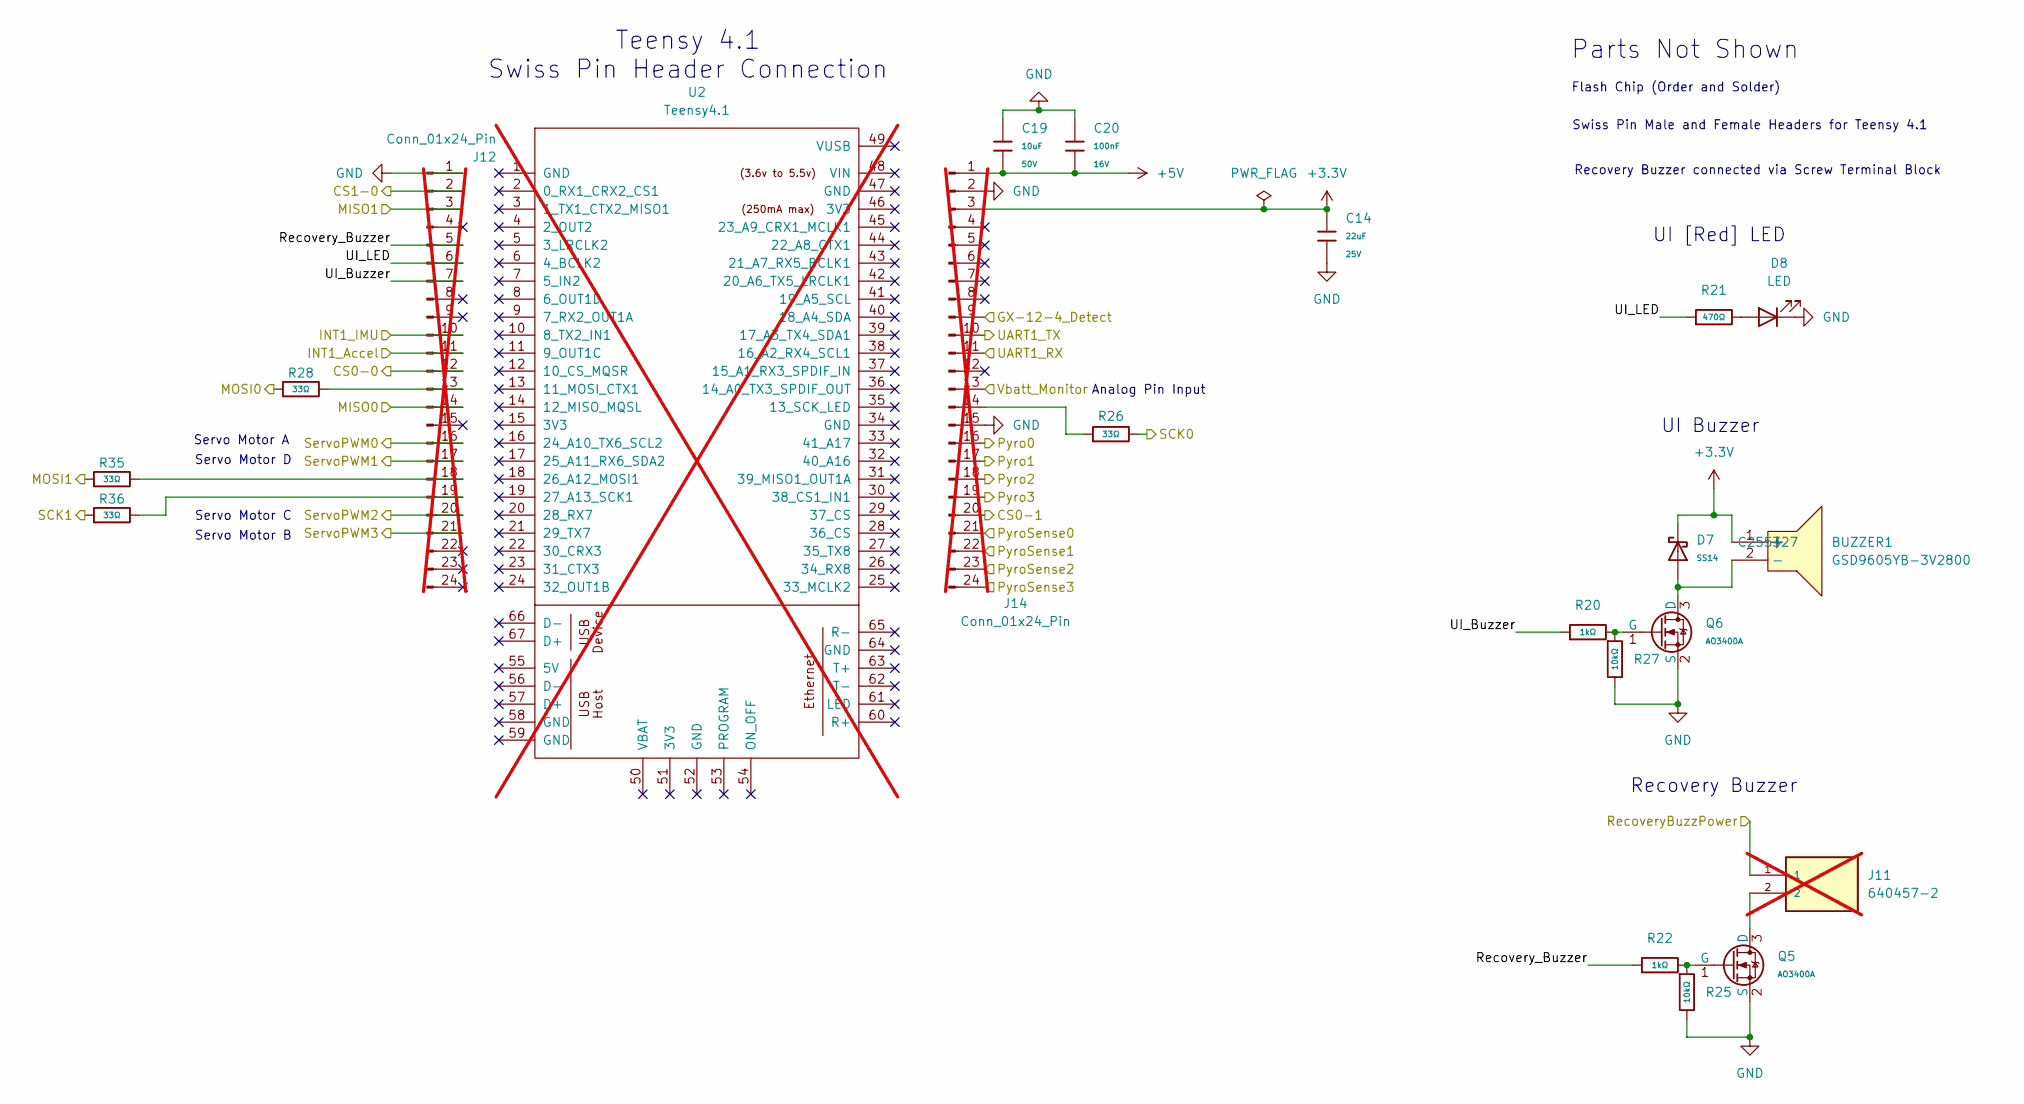
[picture p60: schematic MCU.kicad_sch, Pronoia Sustainer Flight Computer]

Parts:
BUZZER1: GSD9605YB-3V2800; BUZ-SMD_GSD9605YB-3V2800; LCSC C255327
C14: 22uF; C_0805; Voltage Rated 25V; Tolerance ±20%; Part CL21A226MAQNNNE; LCSC C45783
C19: 10uF; C_1206; Voltage Rated 50V; Tolerance ±10%; Part CL31A106KBHNNNE; LCSC C13585
C20: 100nF; C_0402; Voltage Rated 16V; Tolerance ±10%; Part CL05B104KO5NNNC; LCSC C1525
D7: SS14; D_SMA; Forward Voltage (Vf@If) 550mV@1A; Reverse Voltage (Vr) 40V; Part SS14; LCSC C2480
D8: LED; LED_0603_1608Metric; LCSC C3030991
J11: 640457-2; TE_640457-2; PARTREV R; not fitted
J12, J14: Conn_01x24_Pin; PinSocket_1x24_P2.54mm_Vertical; not fitted
Q5, Q6: AO3400A; Q_SOT-23; Part AO3400A; LCSC C20917
R20, R22: 1kΩ; R_0805; Overload Voltage (Max) 150V; Tolerance ±1%; Part 0805W8F1001T5E; LCSC C17513
R21: 470Ω; R_0402; Overload Voltage (Max) 50V; Tolerance ±1%; Part 0402WGF4700TCE; LCSC C25117
R25, R27: 10kΩ; R_0805; Overload Voltage (Max) 150V; Tolerance ±1%; Part 0805W8F1002T5E; LCSC C17414
R26, R28, R35, R36: 33Ω; R_0402; Overload Voltage (Max) 50V; Tolerance ±1%; Part 0402WGF330JTCE; LCSC C25105
U2: Teensy4.1; Teensy41; not fitted

Connections:
+3.3V: BUZZER1.1 (+), C14.1, D7.1, J14.3; also elsewhere on the board
+5V: C19.2, C20.1, J14.1; also elsewhere on the board
/Communications/GX-12-4_Detect: J14.9; also elsewhere on the board
/Communications/GX-12-4_RX: J14.10; also elsewhere on the board
/Communications/GX-12-4_TX: J14.11; also elsewhere on the board
/Flight Computer/CS0-0: J12.12; also elsewhere on the board
/Flight Computer/CS0-1: J14.20; also elsewhere on the board
/Flight Computer/CS1-0: J12.2; also elsewhere on the board
/Flight Computer/INT1_Accel: J12.11; also elsewhere on the board
/Flight Computer/INT1_IMU: J12.10; also elsewhere on the board
/Flight Computer/MISO0: J12.14; also elsewhere on the board
/Flight Computer/MISO1: J12.3; also elsewhere on the board
/Flight Computer/MOSI0: R28.1; also elsewhere on the board
/Flight Computer/MOSI1: R35.1; also elsewhere on the board
/Flight Computer/Pyro0: J14.16; also elsewhere on the board
/Flight Computer/Pyro1: J14.17; also elsewhere on the board
/Flight Computer/Pyro2: J14.18; also elsewhere on the board
/Flight Computer/Pyro3: J14.19; also elsewhere on the board
/Flight Computer/PyroSense0: J14.21; also elsewhere on the board
/Flight Computer/PyroSense1: J14.22; also elsewhere on the board
/Flight Computer/PyroSense2: J14.23; also elsewhere on the board
/Flight Computer/PyroSense3: J14.24; also elsewhere on the board
/Flight Computer/RecoveryBuzzPower: J11.1; also elsewhere on the board
/Flight Computer/Recovery_Buzzer: J12.5, R22.1
/Flight Computer/SCK0: R26.2; also elsewhere on the board
/Flight Computer/SCK1: R36.1; also elsewhere on the board
/Flight Computer/ServoPWM0: J12.16; also elsewhere on the board
/Flight Computer/ServoPWM1: J12.17; also elsewhere on the board
/Flight Computer/ServoPWM2: J12.20; also elsewhere on the board
/Flight Computer/ServoPWM3: J12.21; also elsewhere on the board
/Flight Computer/UI_Buzzer: J12.7, R20.1
/Flight Computer/UI_LED: J12.6, R21.1
/Flight Computer/Vbatt_Monitor: J14.13; also elsewhere on the board
GND: C14.2, C19.1, C20.2, D8.1 (K), J12.1, J14.2, J14.15, Q5.2 (S), Q6.2 (S), R25.2, R27.2; also elsewhere on the board
unnamed: BUZZER1.2 (-), D7.2, Q6.3 (D)
unnamed: D8.2 (A), R21.2
unnamed: J12.13, R28.2
unnamed: J12.18, R35.2
unnamed: J12.19, R36.2
unnamed: J14.14, R26.1
unnamed: J11.2, Q5.3 (D)
unnamed: Q5.1 (G), R22.2, R25.1
unnamed: Q6.1 (G), R20.2, R27.1

Notes on the sheet:
Parts Not Shown
Recovery Buzzer connected via Screw Terminal Block
Servo Motor C
Analog Pin Input
Swiss Pin Male and Female Headers for Teensy 4.1
Servo Motor D
Teensy 4.1 Swiss Pin Header Connection
Servo Motor B
Servo Motor A
UI [Red] LED
Flash Chip (Order and Solder)
Recovery Buzzer
UI Buzzer

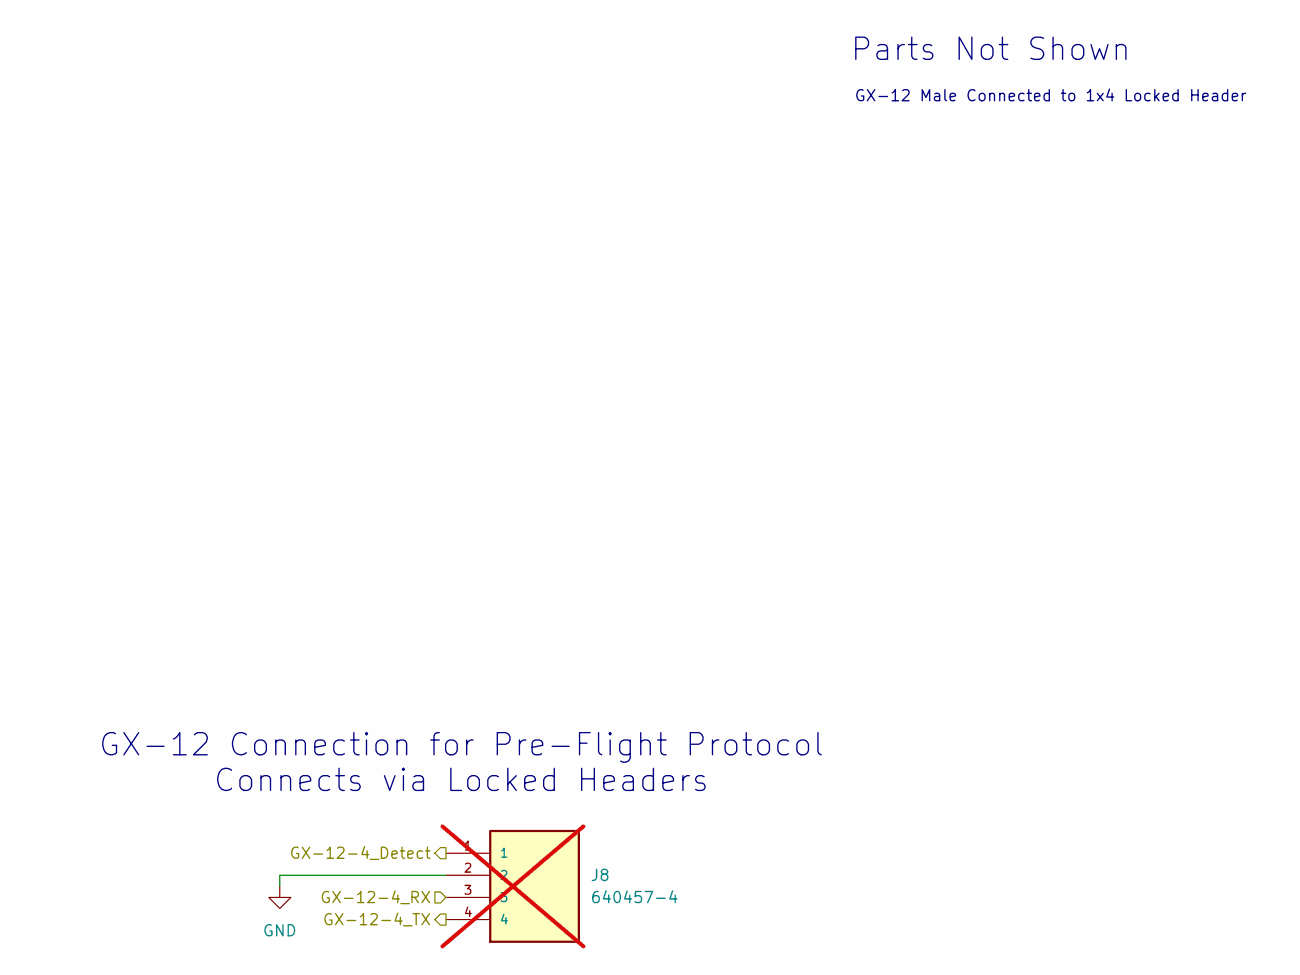
[picture p61: schematic RF.kicad_sch, Pronoia Sustainer Communications]

Parts:
J8: 640457-4; TE_640457-4; PARTREV R; not fitted

Connections:
/Communications/GX-12-4_Detect: J8.1; also elsewhere on the board
/Communications/GX-12-4_RX: J8.3; also elsewhere on the board
/Communications/GX-12-4_TX: J8.4; also elsewhere on the board
GND: J8.2; also elsewhere on the board

Notes on the sheet:
GX-12 Connection for Pre-Flight Protocol Connects via Locked Headers
Parts Not Shown
GX-12 Male Connected to 1x4 Locked Header

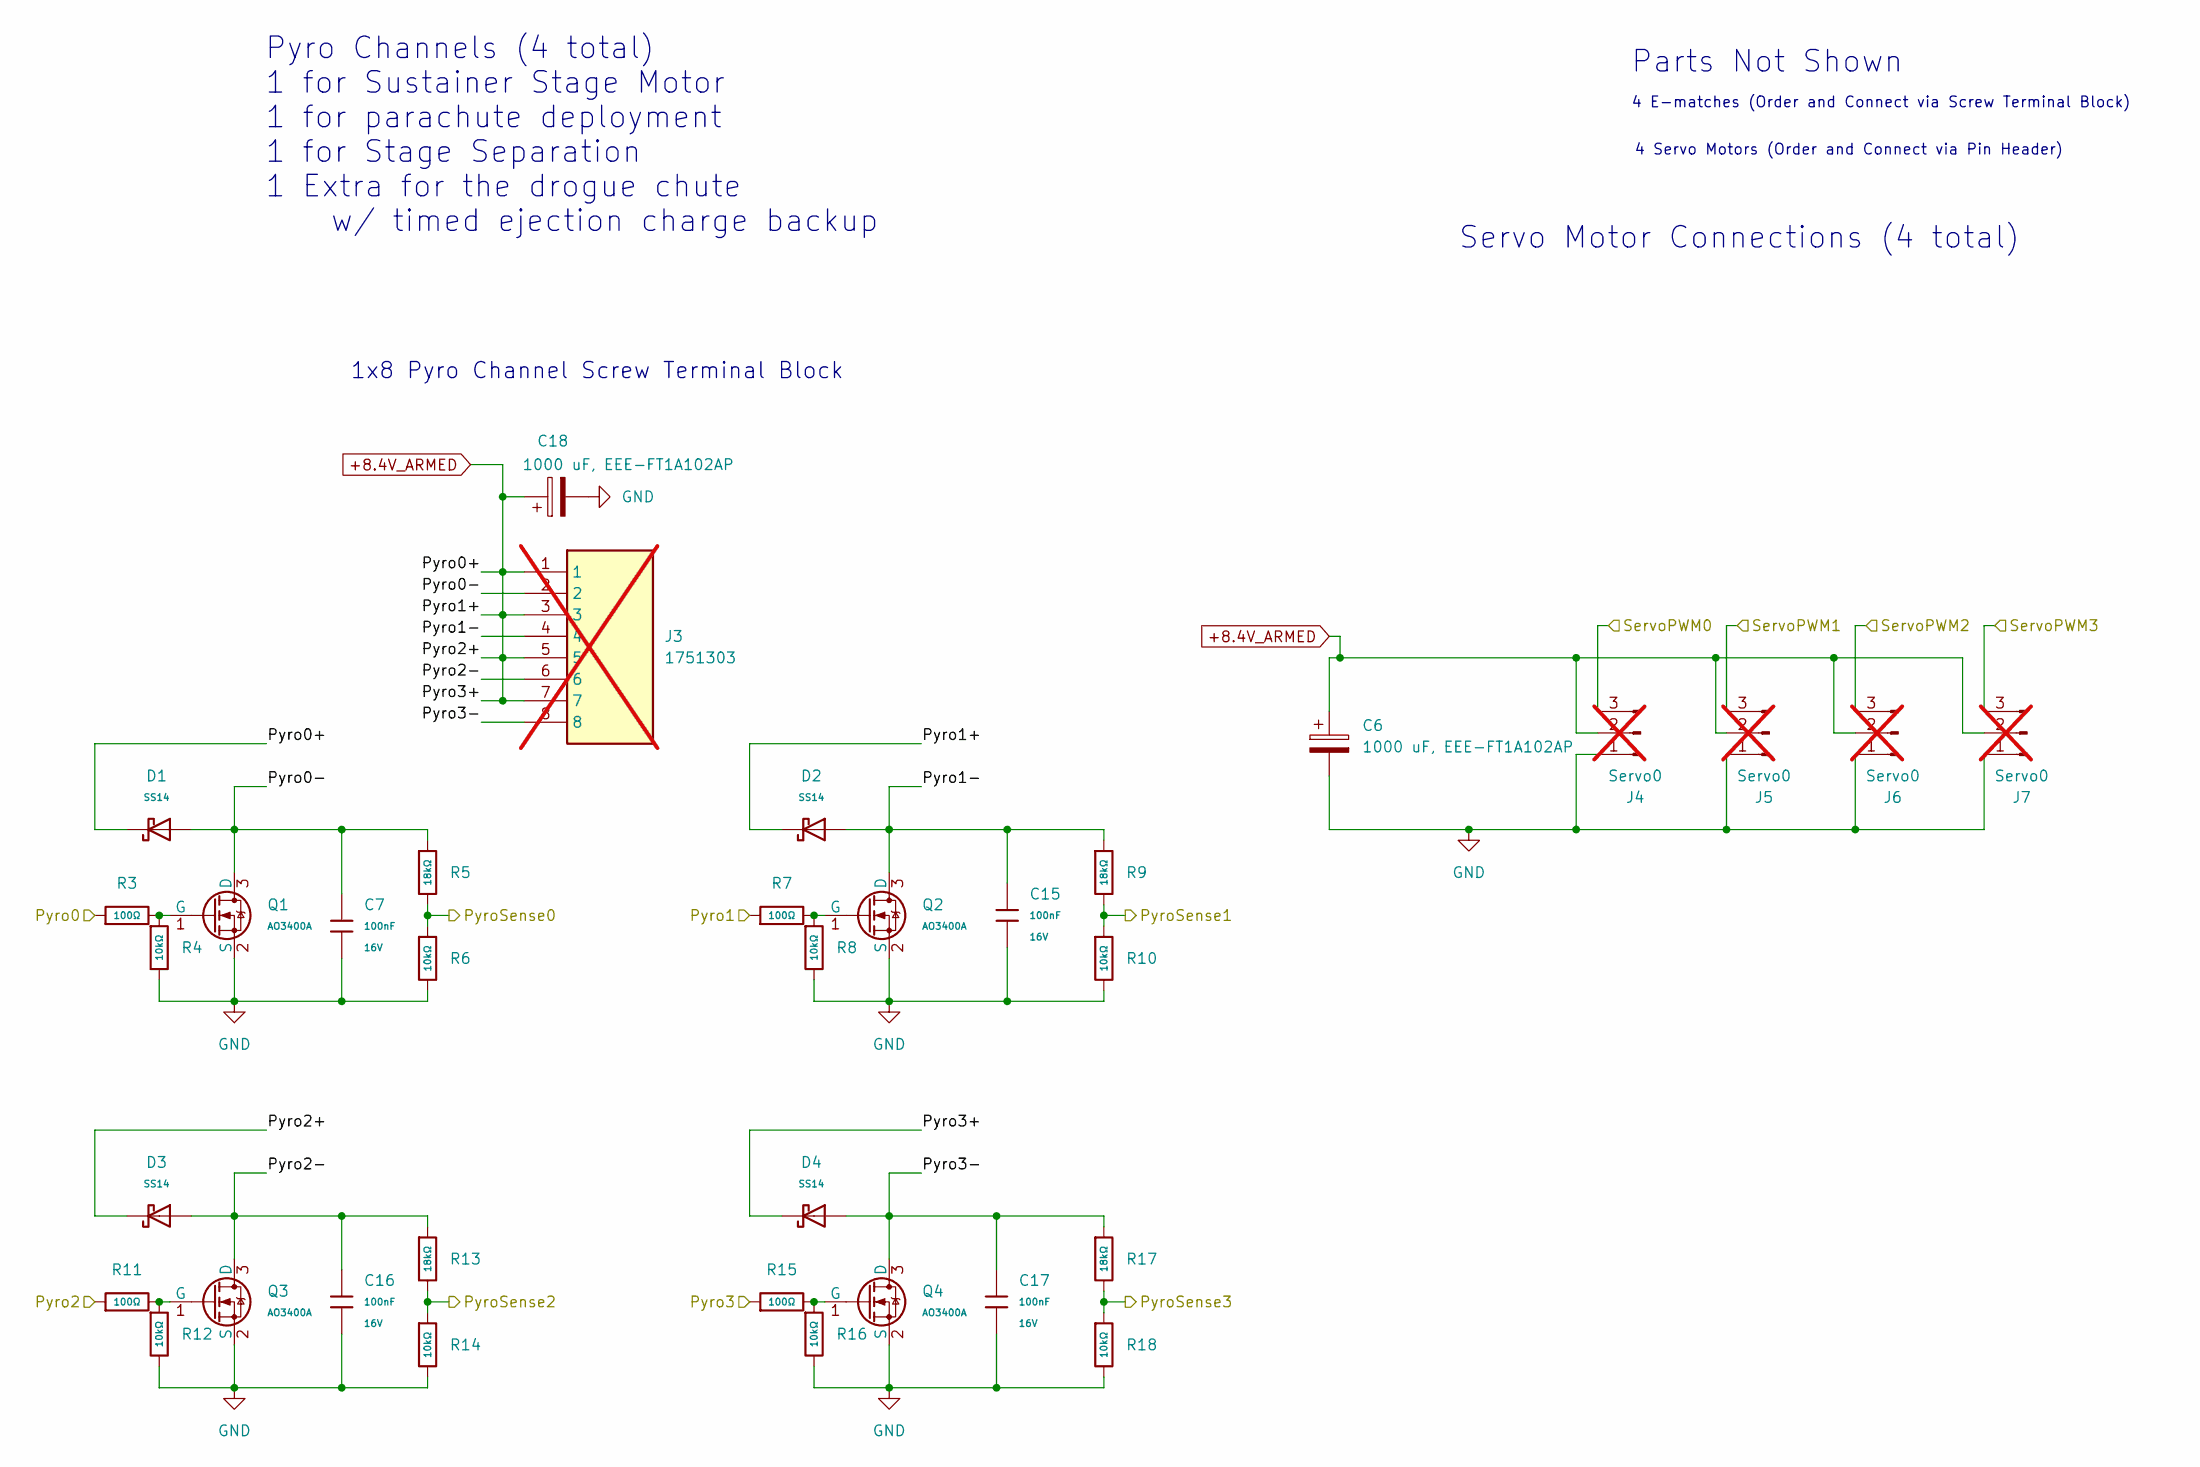
[picture p62: schematic Actuators.kicad_sch, Pronoia Sustainer Actuators]

Parts:
C6, C18: 1000 uF, EEE-FT1A102AP; CP_Elec_8x10.5; LCSC C278408
C7, C15, C16, C17: 100nF; C_0402; Voltage Rated 16V; Tolerance ±10%; Part CL05B104KO5NNNC; LCSC C1525
D1, D2, D3, D4: SS14; D_SMA; Forward Voltage (Vf@If) 550mV@1A; Reverse Voltage (Vr) 40V; Part SS14; LCSC C2480
J3: 1751303; Manufacturer_Part_Number 1751303; Mouser Part Number 651-1751303; not fitted
J4, J5, J6, J7: Servo0; PinHeader_1x03_P2.54mm_Vertical; not fitted
Q1, Q2, Q3, Q4: AO3400A; Q_SOT-23; Part AO3400A; LCSC C20917
R3, R7, R11, R15: 100Ω; R_0805; Overload Voltage (Max) 150V; Tolerance ±1%; Part 0805W8F1000T5E; LCSC C17408
R4, R6, R8, R10, R12, R14, R16, R18: 10kΩ; R_0805; Overload Voltage (Max) 150V; Tolerance ±1%; Part 0805W8F1002T5E; LCSC C17414
R5, R9, R13, R17: 18kΩ; R_0603; Overload Voltage (Max) 75V; Tolerance ±1%; Part 0603WAF1802T5E; LCSC C25810

Connections:
+8.4V_ARMED: C6.1, C18.1, D1.1, D2.1, D3.1, D4.1, J3.1, J3.3, J3.5, J3.7, J4.2, J5.2, J6.2, J7.2; also elsewhere on the board
/Flight Computer/Pyro0: R3.1; also elsewhere on the board
/Flight Computer/Pyro1: R7.1; also elsewhere on the board
/Flight Computer/Pyro2: R11.1; also elsewhere on the board
/Flight Computer/Pyro3: R15.1; also elsewhere on the board
/Flight Computer/PyroSense0: R5.2, R6.1; also elsewhere on the board
/Flight Computer/PyroSense1: R9.2, R10.1; also elsewhere on the board
/Flight Computer/PyroSense2: R13.2, R14.1; also elsewhere on the board
/Flight Computer/PyroSense3: R17.2, R18.1; also elsewhere on the board
/Flight Computer/ServoPWM0: J4.3; also elsewhere on the board
/Flight Computer/ServoPWM1: J5.3; also elsewhere on the board
/Flight Computer/ServoPWM2: J6.3; also elsewhere on the board
/Flight Computer/ServoPWM3: J7.3; also elsewhere on the board
/High-Power Actuators/Pyro0-: C7.1, D1.2, J3.2, Q1.3 (D), R5.1
/High-Power Actuators/Pyro1-: C15.1, D2.2, J3.4, Q2.3 (D), R9.1
/High-Power Actuators/Pyro2-: C16.1, D3.2, J3.6, Q3.3 (D), R13.1
/High-Power Actuators/Pyro3-: C17.1, D4.2, J3.8, Q4.3 (D), R17.1
GND: C6.2, C7.2, C15.2, C16.2, C17.2, C18.2, J4.1, J5.1, J6.1, J7.1, Q1.2 (S), Q2.2 (S), Q3.2 (S), Q4.2 (S), R4.2, R6.2, R8.2, R10.2, R12.2, R14.2, R16.2, R18.2; also elsewhere on the board
unnamed: Q1.1 (G), R3.2, R4.1
unnamed: Q2.1 (G), R7.2, R8.1
unnamed: Q3.1 (G), R11.2, R12.1
unnamed: Q4.1 (G), R15.2, R16.1

Notes on the sheet:
4 E-matches (Order and Connect via Screw Terminal Block)
Parts Not Shown
Pyro Channels (4 total) 1 for Sustainer Stage Motor 1 for parachute deployment 1 for Stage Separation 1 Extra for the drogue chute w/ timed ejection charge backup
1x8 Pyro Channel Screw Terminal Block
4 Servo Motors (Order and Connect via Pin Header)
Servo Motor Connections (4 total)

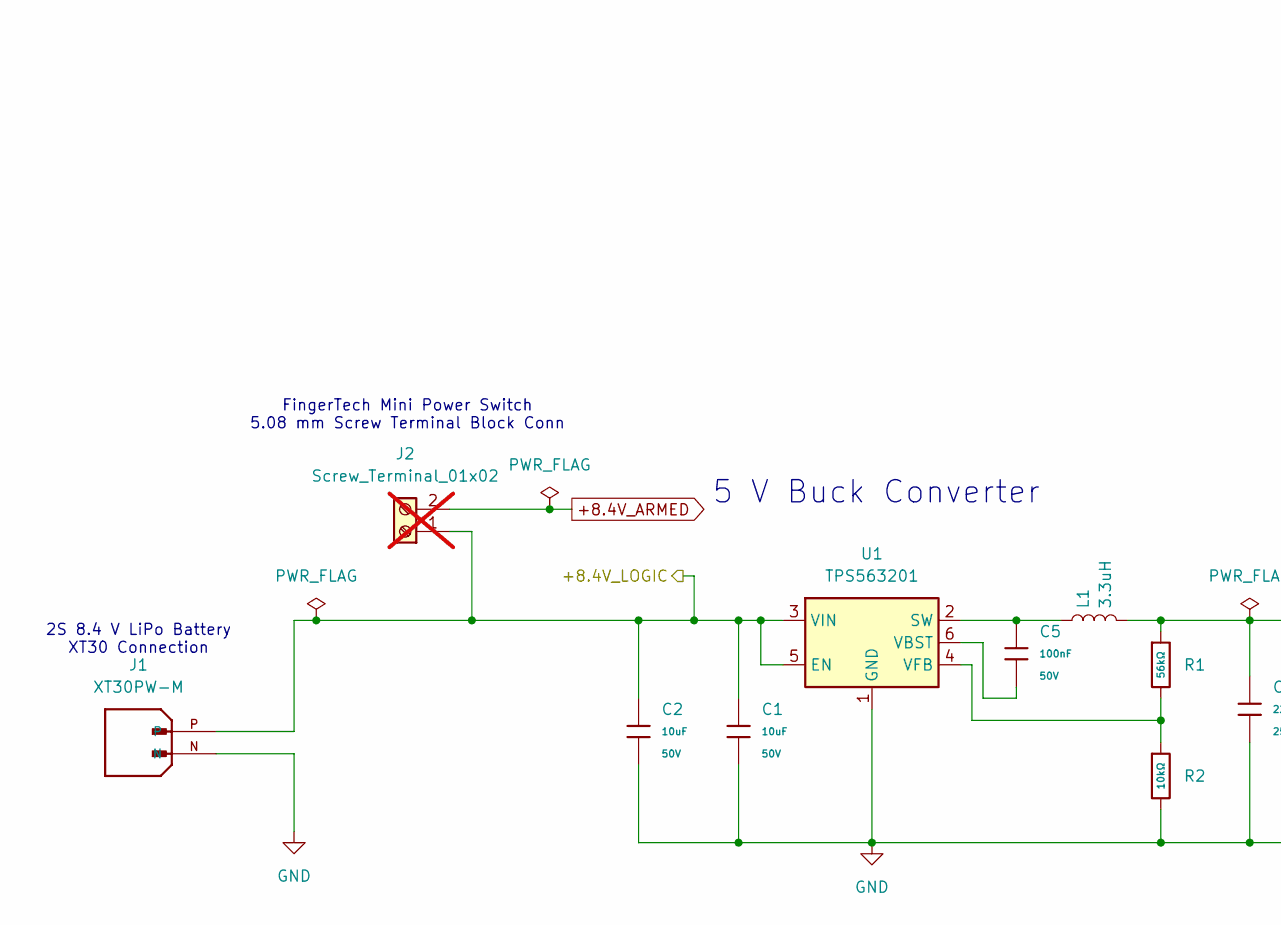
[picture p63: schematic Power.kicad_sch, Pronoia Sustainer Power Management, part in row 1, column 1]

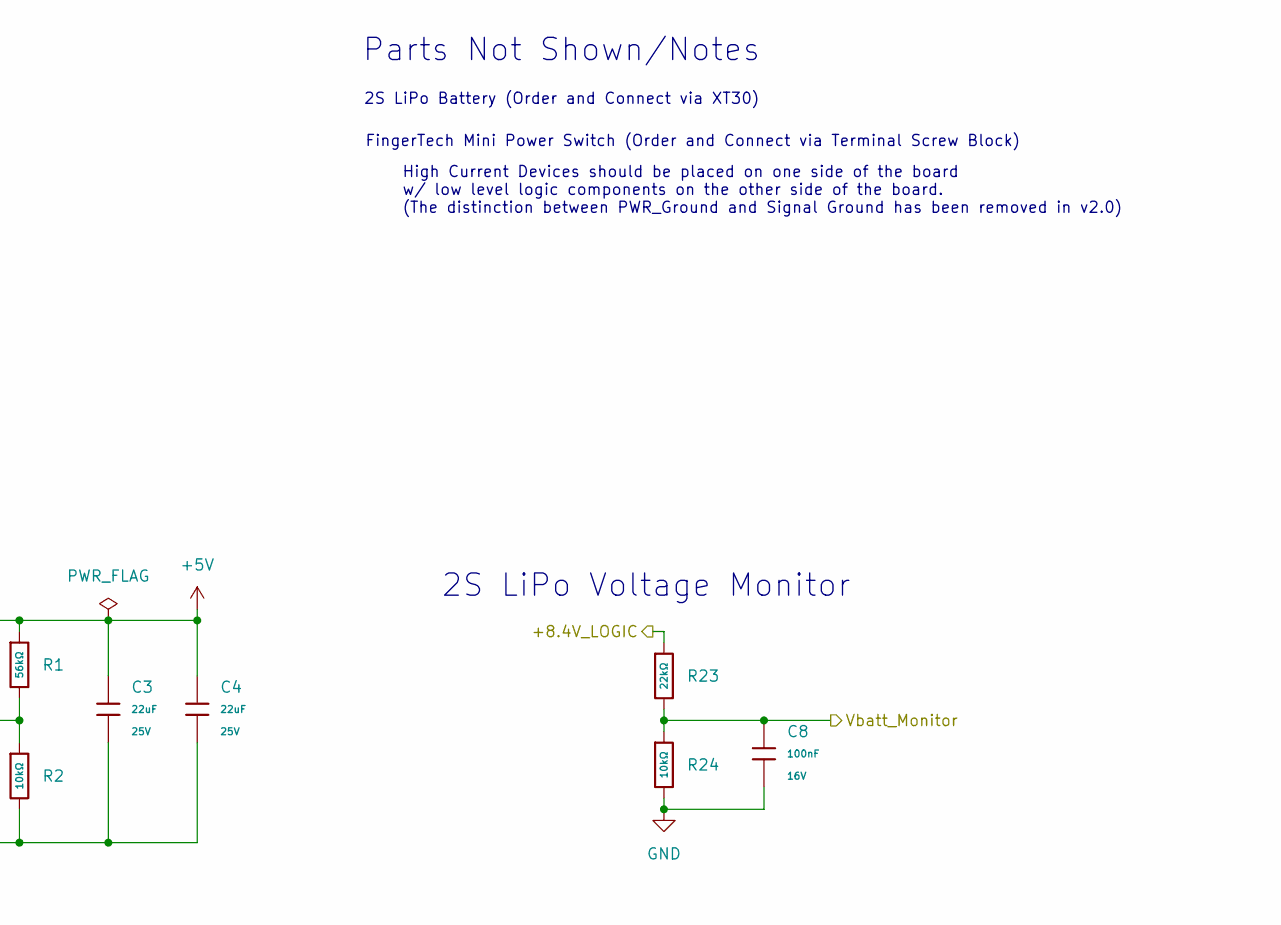
[picture p64: schematic Power.kicad_sch, Pronoia Sustainer Power Management, part in row 1, column 2]

Parts:
C1, C2: 10uF; C_1206; Voltage Rated 50V; Tolerance ±10%; Part CL31A106KBHNNNE; LCSC C13585
C3, C4: 22uF; C_0805; Voltage Rated 25V; Tolerance ±20%; Part CL21A226MAQNNNE; LCSC C45783
C5: 100nF; C_1206; Voltage Rated 50V; Tolerance ±10%; Part CL31B104KBCNNNC; LCSC C24497
C8: 100nF; C_0402; Voltage Rated 16V; Tolerance ±10%; Part CL05B104KO5NNNC; LCSC C1525
J1: XT30PW-M; AMASS_XT30PW-M; PARTREV 1.2; LCSC C431092
J2: Screw_Terminal_01x02; TerminalBlock_Phoenix_MKDS-1,5-2-5.08_1x02_P5.08mm_Horizont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; not fitted
L1: 3.3uH; L_Bourns-SRN8040_8x8.15mm; LCSC C780188
R1: 56kΩ; R_0603; Overload Voltage (Max) 75V; Tolerance ±1%; Part 0603WAF5602T5E; LCSC C23206
R2: 10kΩ; R_0603; Overload Voltage (Max) 75V; Tolerance ±1%; Part 0603WAF1002T5E; LCSC C25804
R23: 22kΩ; R_0805; Overload Voltage (Max) 150V; Tolerance ±1%; Part 0805W8F2202T5E; LCSC C17560
R24: 10kΩ; R_0805; Overload Voltage (Max) 150V; Tolerance ±1%; Part 0805W8F1002T5E; LCSC C17414
U1: TPS563201; SOT-23-6; LCSC C116592

Connections:
+5V: C3.1, C4.1, L1.2, R1.1; also elsewhere on the board
+8.4V_ARMED: J2.2; also elsewhere on the board
/Flight Computer/RecoveryBuzzPower: C1.1, C2.1, J1.P, J2.1, R23.1, U1.3 (VIN), U1.5 (EN); also elsewhere on the board
/Flight Computer/Vbatt_Monitor: C8.1, R23.2, R24.1; also elsewhere on the board
GND: C1.2, C2.2, C3.2, C4.2, C8.2, J1.N, R2.2, R24.2, U1.1 (GND); also elsewhere on the board
unnamed: C5.1, L1.1, U1.2 (SW)
unnamed: C5.2, U1.6 (VBST)
unnamed: R1.2, R2.1, U1.4 (VFB)

Notes on the sheet:
5 V Buck Converter
FingerTech Mini Power Switch 5.08 mm Screw Terminal Block Conn
2S LiPo Voltage Monitor
High Current Devices should be placed on one side of the board w/ low level logic components on the other side of the board. (The distinction between PWR_Ground and Signal Ground has been removed in v2.0)
2S 8.4 V LiPo Battery XT30 Connection
2S LiPo Battery (Order and Connect via XT30)
FingerTech Mini Power Switch (Order and Connect via Terminal Screw Block)
Parts Not Shown/Notes

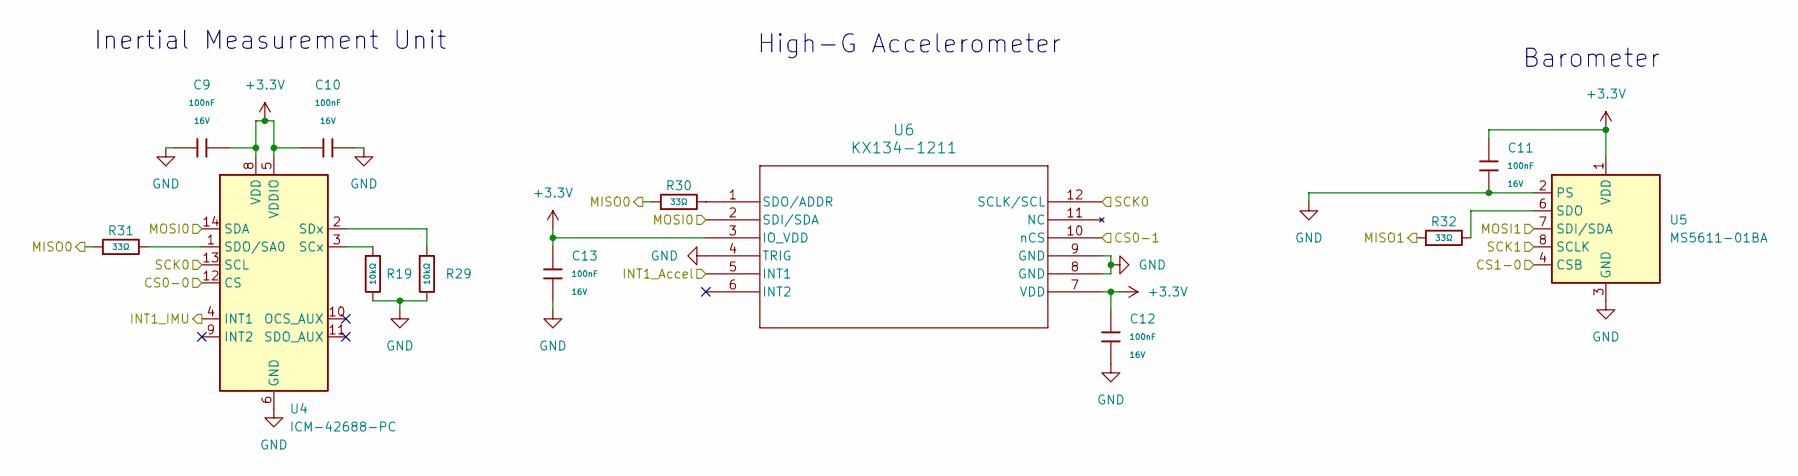
[picture p65: schematic Sensors.kicad_sch, Pronoia Sustainer Sensors]

Parts:
C9, C10, C11, C12, C13: 100nF; C_0402; Voltage Rated 16V; Tolerance ±10%; Part CL05B104KO5NNNC; LCSC C1525
R19, R29: 10kΩ; R_0805; Overload Voltage (Max) 150V; Tolerance ±1%; Part 0805W8F1002T5E; LCSC C17414
R30, R31, R32: 33Ω; R_0402; Overload Voltage (Max) 50V; Tolerance ±1%; Part 0402WGF330JTCE; LCSC C25105
U4: ICM-42688-PC; LGA-14_3x2.5mm_P0.5mm_LayoutBorder3x4y; LCSC C48586483
U5: MS5611-01BA; LGA-8_3x5mm_P1.25mm; LCSC C15639
U6: KX134-1211; KIONIX_KXTJ3-1057; LCSC C2157908

Connections:
+3.3V: C9.2, C10.1, C11.2, C12.2, C13.2, U4.5 (VDDIO), U4.8 (VDD), U5.1 (VDD), U6.3 (IO_VDD), U6.7 (VDD); also elsewhere on the board
/Flight Computer/CS0-0: U4.12 (CS); also elsewhere on the board
/Flight Computer/CS0-1: U6.10 (nCS); also elsewhere on the board
/Flight Computer/CS1-0: U5.4 (CSB), U5.5 (CSB); also elsewhere on the board
/Flight Computer/INT1_Accel: U6.5 (INT1); also elsewhere on the board
/Flight Computer/INT1_IMU: U4.4 (INT1); also elsewhere on the board
/Flight Computer/MISO0: R30.1, R31.1; also elsewhere on the board
/Flight Computer/MISO1: R32.1; also elsewhere on the board
/Flight Computer/MOSI0: U4.14 (SDA), U6.2 (SDI/SDA); also elsewhere on the board
/Flight Computer/MOSI1: U5.7 (SDI/SDA); also elsewhere on the board
/Flight Computer/SCK0: U4.13 (SCL), U6.12 (SCLK/SCL); also elsewhere on the board
/Flight Computer/SCK1: U5.8 (SCLK); also elsewhere on the board
GND: C9.1, C10.2, C11.1, C12.1, C13.1, R19.2, R29.2, U4.6 (GND), U4.7 (GND), U5.2 (PS), U5.3 (GND), U6.4 (TRIG), U6.8 (GND), U6.9 (GND); also elsewhere on the board
unnamed: R19.1, U4.3 (SCx)
unnamed: R31.2, U4.1 (SDO/SA0)
unnamed: R29.1, U4.2 (SDx)
unnamed: R32.2, U5.6 (SDO)
unnamed: R30.2, U6.1 (SDO/ADDR)

Notes on the sheet:
High-G Accelerometer
Barometer
Inertial Measurement Unit

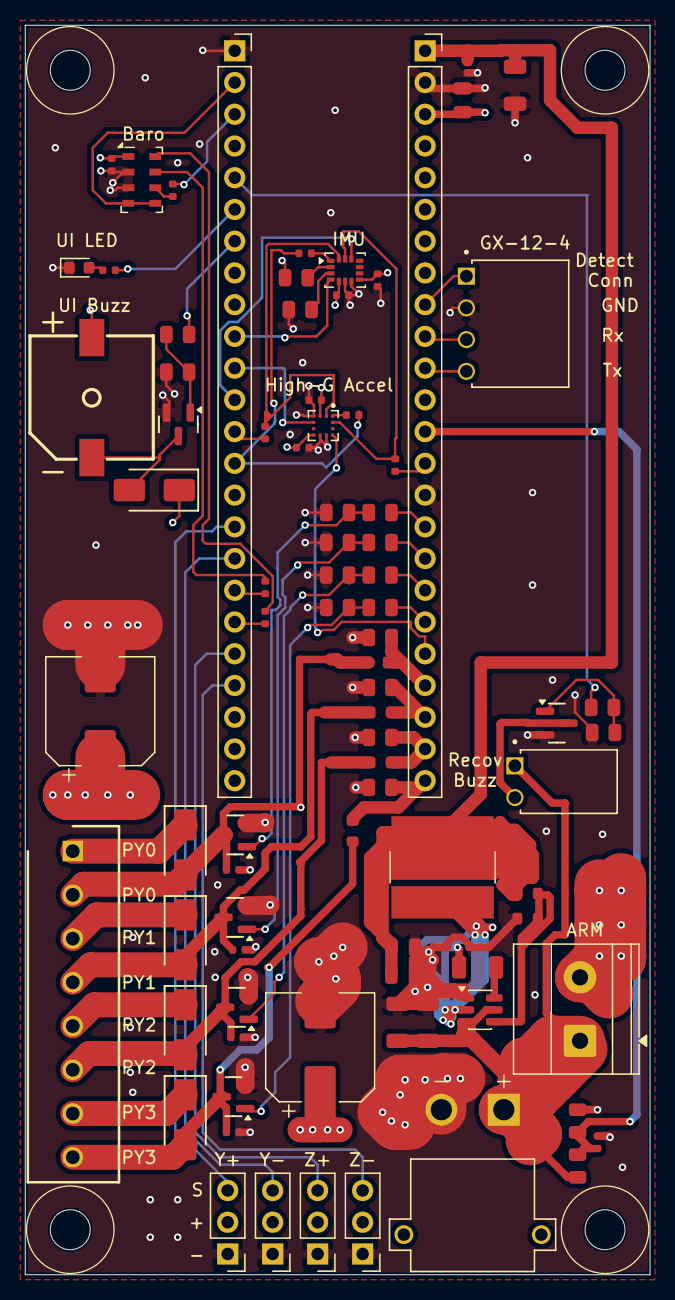
[picture p66: board Pronoia_Sustainer.kicad_pcb from above]

Board: 4 copper layers, 50.0 x 100.0 mm, 83 parts (0 on the bottom side), 60 nets.
