nguyjo/Project_Prometheus/(commit log)

2026-01-23 Added .gitignore and created KiCAD projects
    [Atlas_Booster.kicad_pcb, Atlas_Booster.kicad_sch, Pronoia_Sustainer.kicad_pcb, Pronoia_Sustainer.kicad_sch]
2026-01-24 Initial start for Pronoia Schematic
    [Pronoia_Sustainer.kicad_sch]
2026-01-25 Added 1st Pyro Channel w/ Continuity Testing
    [Pronoia_Sustainer.kicad_sch]
2026-01-26 Added Servo Motor PWM Pin Headers and Electrolytic Capacitor
    [Pronoia_Sustainer.kicad_sch]
2026-01-29 PyroChannel LTSpice Confirmation, Added LDO Regulator, Heirarchical Sheet
    [Pronoia_Sustainer.kicad_sch, PyroChannels.kicad_sch]
2026-01-29 Added footprints to all placed symbols
    [Pronoia_Sustainer.kicad_pcb, Pronoia_Sustainer.kicad_sch, PyroChannels.kicad_sch, Teensy_4.0_Assembly.STEP, XT30PW-M.step]
2026-01-30 Added PyroChannel Sim, Organized directory
    [Atlas_Booster.kicad_pcb, Atlas_Booster.kicad_sch, Pronoia_Sustainer.kicad_pcb, Pronoia_Sustainer.kicad_sch, PyroChannels.kicad_sch]
2026-01-30 Added IMU and connections
    [Pronoia_Sustainer.kicad_sch]
2026-01-31 Added communication symbols to schematic
    [Pronoia_Sustainer.kicad_sch]
2026-02-02 Completed 1st Draft
    [Actuators.kicad_sch, MCU.kicad_sch, Power.kicad_sch, Pronoia_Sustainer.kicad_sch, RF.kicad_sch, Sensors.kicad_sch]
2026-02-04 updated Schematics
    [MCU.kicad_sch, Power.kicad_sch, Pronoia_Sustainer.kicad_sch, RF.kicad_sch]
2026-02-04 Completed 1st draft of Schematic
    [Actuators.kicad_sch, MCU.kicad_sch, Power.kicad_sch, Pronoia_Sustainer.kicad_sch, RF.kicad_sch]
2026-02-20 Last commit for KiCAD schematic w/ GPS, Telem, and Bluetooth
    [Actuators.kicad_sch, MCU.kicad_sch, Power.kicad_sch, Pronoia_Sustainer.kicad_sch, RF.kicad_sch, Sensors.kicad_sch]
2026-03-02 Red LED and UI Buzzer Circuit
    [MCU.kicad_sch, Sensors.kicad_sch]
2026-03-04 Finalized v2.0 of Pronoia Schematic
    [Actuators.kicad_sch, MCU.kicad_sch, Power.kicad_sch, Pronoia_Sustainer.kicad_pcb, Pronoia_Sustainer.kicad_sch, RF.kicad_sch, Sensors.kicad_sch]
2026-03-12 Finished PCB layout
    [Actuators.kicad_sch, MCU.kicad_sch, Power.kicad_sch, Pronoia_Sustainer.kicad_pcb, Pronoia_Sustainer.kicad_sch, RF.kicad_sch, Sensors.kicad_sch]
2026-04-28 Sensor Bring-Up
    [Actuators.kicad_sch, MCU.kicad_sch, Power.kicad_sch, Pronoia_Sustainer.kicad_pcb, Pronoia_Sustainer.kicad_sch, Pronoia_Sustainer_BOM.csv, RF.kicad_sch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]
2026-05-01 Driver codes; axis orientation verified
2026-05-02 Barometer-based Velocity Estimate
2026-06-22 Updated codebase
    [MCU.kicad_sch, Pronoia_Sustainer.kicad_pcb]
2026-06-22 Prometheus BOM Master
    [Prometheus_Avionics_BOM_Master v2.0.csv]
2026-06-22 External Parts BOM
    [External_Parts_BOM.csv]
2026-06-22 Energy Budget Calculation
    [Energy Budget Calculation.csv]
2026-06-22 Energy Budget Calculation update
    [Energy Budget Calculation.csv]
